59psi/SporePrint/docs/dual-repo-architecture.md

# Dual-Repository Architecture

Open-source Pi-side core + private commercial cloud layer. The commercial repo consumes the open-source one as a git submodule and adds the cloud relay, the browser cloud-web shell and the subscription / admin layer. A React Native mobile app is being rebuilt there and is not released.

**v3.4 business-model clarification**: this public repo (the Pi side) is free, open-source AGPL-3.0. The private repo (cloud + cloud-web, and the mobile app once it ships) is entirely a paid commercial product — `require_premium` (402 `subscription_required`) gates every cloud data endpoint, the cloud relay refuses free Socket.IO clients, and the cloud-web edge middleware redirects free users to `/pricing?upsell=1`. That doesn't change anything about the Pi's behavior or the git-submodule coupling documented below. It does mean that if you're running the Pi standalone without a commercial subscription, the "commercial layer" half of this diagram is invisible to you — and that's a supported configuration.

**v4 layout shift on the private side**: the private browser surfaces and the Pi dashboard source now live in one pnpm monorepo. There is no released mobile app. The cloud web app is a Next.js 16 App Router app that ships **inside the same Railway service and Docker image** as the FastAPI cloud (`cloud/`). There is no `api.sporeprint.ai` subdomain and no separate Railway service — Next.js binds to `$PORT` and proxies `/api/*`, `/socket.io/*`, `/health/*`, `/docs/*`, `/firmware/*`, `/subscriptions/*`, `/webhooks/*` to FastAPI on internal `127.0.0.1:9001`. From this Pi-side repo's perspective, none of that matters: the cloud connector still talks to `https://sporeprint.ai`.

```mermaid
flowchart TB
    subgraph Public["PUBLIC · sporeprint · AGPL-3.0 · github.com/59psi/SporePrint"]
        Server["Pi Server<br/>Python 3.11+ · FastAPI<br/>20 modules · 150 endpoints<br/>SQLite · aiomqtt · Socket.IO<br/>Bearer-token gate (v3.3.0)"]
        Firmware["Firmware<br/>C++ · PlatformIO · Arduino-ESP32 core 3.3<br/>Unified node (climate · relay · lighting) + camera<br/>(AI-Thinker + 3 ESP32-S3 camera boards)<br/>Auth'd MQTT · signed commands · OTA pwd + rollback<br/>signed OTA manifests · offline buffer · health · coredump ack"]
        WebUI["Web UI (compiled bundle in ui/dist)<br/>React 19 · Vite 8 · Tailwind v4<br/>21 pages · @sporeprint/design · REST<br/>Chambers · Sessions · Species<br/>Automation · Vision · Builder"]
    end

    subgraph Private["PRIVATE · Commercial Layer · Paid"]
        Cloud["Cloud Backend (FastAPI + Socket.IO)<br/>Relay · Auth · Push · AI<br/>Metrics · Subscriptions<br/>HMAC-signed commands (v3.3.1)<br/>FastAPI on internal 127.0.0.1:9001<br/>(Next on $PORT, same Railway image)"]
        CloudWeb["Cloud-Web (Next.js 16 App Router)<br/>Server-rendered React<br/>Edge tier middleware<br/>Stripe Checkout · Web push (VAPID)<br/>Same Railway image, public on $PORT"]
        Mobile["Mobile App (React Native)<br/>being rebuilt · not released"]
    end

    Private -.->|git submodule · generated species, phase + Builder data| Public

    Services["Cloud-side services<br/>Supabase · Railway · RevenueCat · Stripe · Firebase<br/>Resend · Sentry · Cloudflare · Claude (cloud AI)"]
    PiExt["Pi-side, optional<br/>Claude API (your own key) · weather providers<br/>(Open-Meteo · OpenWeatherMap · NWS)"]

    Cloud --- Services
    Server -.- PiExt

    classDef public fill:#1a2a1f,stroke:#3dd68c,color:#dfd;
    classDef private fill:#1a1f2a,stroke:#6b93d6,color:#ddf;
    classDef svc fill:#231a2a,stroke:#a06bd6,color:#e8d8ff;
    class Server,Firmware,WebUI public;
    class Cloud,CloudWeb,Mobile private;
    class Services,PiExt svc;
```

## Tier model at the boundary (v3.4+ / v4)

| Capability | Free (Pi self-host, OSS) | Subscription ($4.99/mo · $39.99/yr) |
|---|---|---|
| Pi software (this repo) | ✓ AGPL-3.0, run it yourself | ✓ |
| Pi's own web UI on LAN | ✓ Full control, no paygate | ✓ |
| Remote access | The Pi's own web UI over your own Tailscale | Cloud relay through the web app (HMAC-signed commands) |
| Mobile app | Not available: the React Native app is being rebuilt | Not available yet |
| Cloud-web (`sporeprint.ai`) | ✗ Edge middleware redirects to `/pricing?upsell=1` | ✓ Full |
| Pair Pi to commercial cloud | ✗ (`/devices/pair` → 402) | ✓ |
| Push notifications | ntfy on the Pi (LAN) | ntfy on the Pi, plus browser notifications from `sporeprint.ai` (Web Push) |
| AI vision + advisor on the Pi | ✓ BYOK (your own Anthropic key, stored on the Pi) | ✓ BYOK on-Pi OR cloud-managed |
| Cloud AI (`/ai/*`) | ✗ (`require_premium` returns 402) | ✓ rate-limited or BYOK for unlimited |
| Cultures / Experiments / Planner (cloud) | ✗ | ✓ (added in v4) |
| Analytics / export / historical data durability | ✗ | ✓ |

Key boundary: the Pi itself has **no paygate**. All paywalling lives in the commercial cloud (`require_premium` for REST, `subscription_required` for relay Socket.IO) and the cloud-web edge middleware (`tier === 'premium'` check on every protected route). A Pi-only user never encounters either.

## Repo coupling contract

- The private repo **pins** a specific public-repo SHA (the submodule gitlink in its tree; `.gitmodules` holds only the path and URL). Bumping it is an explicit `git add sporeprint/` + commit, never a floating pointer.
- **Lockstep version bumps**: the parent's `scripts/bump.sh` is the single authority — it edits `cloud/pyproject.toml` (the canonical version), `sporeprint/server/pyproject.toml`, `sporeprint/server/app/main.py`, `sporeprint/firmware/VERSION.txt`, the Pi README's `**Version:**` line and the monorepo's own packages (the Pi UI's version lives in `frontend/packages/pi-ui`; `ui/dist` is rebuilt out of band) so every shipped artifact reports the same version. The Pi-side does not have its own `bump.sh`.
- **Pi UI source vs bundle**: the source lives in the parent at `frontend/packages/pi-ui/`; the compiled output lands in the submodule at `sporeprint/ui/dist/`. The submodule's `.gitignore` has an explicit `!ui/dist/` exception so the prebuilt bundle is committed. The Pi pulls the submodule and serves the bundle locally — no Node toolchain required on the Pi.
- The species library auto-syncs: `frontend/packages/design/src/data/speciesProfiles.ts` is generated from `sporeprint/server/app/species/profiles.py` by the parent's `scripts/port_species.py`, so the Pi remains the source of truth for the 74-entry library; `scripts/port_enums.py` generates the dashboard's phase list from the Pi's `GrowPhase`, and `scripts/port_builder.py` the Builder page's built-in BOM, model and firmware data.
- The private repo **never modifies** submodule files in-place from cloud-side branches. Submodule edits land via a branch + PR inside `sporeprint/`, then the parent bumps the pointer via `scripts/bump.sh` and `scripts/sync-after-merge.sh` (the post-merge script reconciles the submodule SHA after GitHub's squash-merge rewrites).
- The public-repo tests (`cd sporeprint/server && pytest`) must stay green after any private-repo-driven public change. No CI runs on push or PR, so the local checks (`AGENTS.md` → Commands) and the release checklist are the gate.

## What lives where (v4)

| Concern | Public (sporeprint) | Private (commercial cloud) |
|---|---|---|
| Telemetry ingest | ✅ mqtt.py + aiosqlite | — |
| Automation engine | ✅ (safety watchdog, overrides, rules) | — |
| Pi local UI source code | — | ✅ (parent monorepo) |
| Pi local UI compiled bundle | ✅ `sporeprint/ui/dist/` (git-tracked via `!ui/dist/` exception) | builds into the submodule |
| Vision stub + Claude via Pi | ✅ | — |
| Mobile client | — | ✅ rebuild in progress, not released |
| Cloud-web shell (Next.js 16) | — | ✅ |
| Cloud relay + Socket.IO rooms | — | ✅ |
| Auth (Supabase JWT verify) | — | ✅ |
| Subscriptions (RevenueCat mobile + Stripe web) | — | ✅ |
| Admin (overrides, promos, broadcasts) | — | ✅ |
| ESP32 firmware | ✅ | — |
| Cloud HMAC command signing | verify side | sign side (both at v3.3.1+) |
| OTA bundle signing (Ed25519) | verify on Pi (signed release manifest, `server/app/cloud/ota_manifest.py`); optional manifest check on nodes built with the key; node images signed by this repo's `firmware-release.yml` | Pi-server bundle: signed by the commercial release workflow with `sporeprint/scripts/` |
