59psi/SporePrint/firmware/boards/board_profile_esp32s3.h

#pragma once
//
// Board profile — ESP32-S3-DevKitC-1, platformio envs:
//   node_esp32s3          N8 / N8R8 / N16R8 (quad flash)
//   node_esp32s3_n32r16v  N32R16V (octal flash + octal PSRAM, 1.8 V —
//                         ESP32-S3-WROOM-2 module); defines
//                         SP_BOARD_ESP32S3_N32R16V
//
// One pin map for both. Pin choices avoid: strapping pins (0, 3, 45, 46),
// native USB (19, 20), flash/PSRAM (26–37 on octal modules — the whole
// 26-37 range is the octal bus on the WROOM-2), GPIO 47/48 (1.8 V on the
// N32R16V), and the v1.1 RGB LED (38). SDA/SCL match the DevKitC-1 silk
// defaults. BENCH VERIFICATION PENDING — the BOM keeps WROOM-32 canonical
// until an S3 board passes the checklist.
//
// Included ONLY from src/ composition roots — never from lib/.

#if defined(SP_BOARD_ESP32S3_N32R16V)
#define SP_BOARD_NAME "esp32-s3-devkitc-1-n32r16v"
#else
#define SP_BOARD_NAME "esp32-s3-devkitc-1"
#endif

#define SP_PIN_I2C_SDA 8
#define SP_PIN_I2C_SCL 9

#define SP_CHANNEL_PINS {4, 5, 6, 7}
#define SP_CHANNEL_COUNT 4

#define SP_PIN_HX711_DOUT 10
#define SP_PIN_HX711_SCK 11
#define SP_PIN_REED 12  // full GPIO on S3 — internal pullup works here

#define SP_UART_CO2_RX 16
#define SP_UART_CO2_TX 17

// Factory reset — BOOT button (GPIO 0; read-only use is strapping-safe).
#define SP_PIN_FACTORY_RESET 0

// LEDC: S3 has exactly 8 channels — the bank takes channels 0-3 on ONE timer
// (ledcAttachChannel in src/node/main.cpp); nothing else may claim LEDC on
// this board. Clock: the core runs S3 LEDC from the 40 MHz XTAL — 40 MHz /
// 2^10 = 39 kHz is the 10-bit ceiling, and 25 kHz is the exact divider
// 1.5625 (the LEDC divider has 8 fractional bits).
#define SP_LEDC_FREQ_HZ 25000
#define SP_LEDC_RES_BITS 10
