59psi/SporePrint/server/app/automation/templates.py

"""Built-in automation rule templates seeded on startup."""

from .models import (
    AutomationRule,
    RuleCondition,
    RuleAction,
    ConditionType,
    ThresholdCondition,
    ScheduleCondition,
    CompoundCondition,
    CompoundOp,
)

# Phases in which the substrate sits OPEN in the chamber air and the closet
# holds a humidity / CO2 band and a photoperiod for it: the fruiting run, plus
# shiitake's browning stage — the unbagged block browns at 70-80 % RH, CO2
# under its moderate ceiling, 12/12 light, and the engine's stage alerts
# already page on that band, so the rules that answer them must run there too.
# Scheduled FAE stays fruiting-only (browning is fae_mode="passive").
_OPEN_SUBSTRATE_PHASES = ("browning", "primordia_induction", "fruiting")

BUILTIN_RULES: list[AutomationRule] = [
    # ─── Humidity Control ────────────────────────────────────────
    AutomationRule(
        name="Humidity Boost",
        description="Activate humidifier when humidity drops below species target minimum",
        priority=10,
        condition=RuleCondition(
            type=ConditionType.THRESHOLD,
            threshold=ThresholdCondition(
                sensor="humidity",
                operator="lt",
                profile_ref="humidity_min",
            ),
        ),
        action=RuleAction(target="plug-humidifier", state="on", duration_sec=300),
        cooldown_seconds=120,
        safety_max_on_seconds=1800,
        notification=False,
        log_to_session=True,
    ),
    AutomationRule(
        name="Humidity Cut",
        description="Deactivate humidifier when humidity exceeds species target maximum",
        priority=10,
        condition=RuleCondition(
            type=ConditionType.THRESHOLD,
            threshold=ThresholdCondition(
                sensor="humidity",
                operator="gt",
                profile_ref="humidity_max",
            ),
        ),
        action=RuleAction(target="plug-humidifier", state="off"),
        cooldown_seconds=60,
        log_to_session=True,
    ),
    # Humidity was ONE-DIRECTIONAL until now: the humidifier turned on and off,
    # but nothing REMOVED humidity. A sealed chamber pinned at 95% RH is a
    # contamination event, and Tier 3 ships a dehumidifier plug for exactly it.
    AutomationRule(
        name="Dehumidify",
        description="Run the dehumidifier when humidity exceeds the species maximum",
        priority=10,
        applies_to_phases=list(_OPEN_SUBSTRATE_PHASES),
        condition=RuleCondition(
            type=ConditionType.THRESHOLD,
            threshold=ThresholdCondition(sensor="humidity", operator="gt", profile_ref="humidity_max"),
        ),
        action=RuleAction(target="plug-dehumidifier", state="on", duration_sec=600),
        cooldown_seconds=300,
        safety_max_on_seconds=3600,
        log_to_session=True,
    ),
    # Like the heating/cooling cutoffs, this is true the whole time the chamber
    # is in range, so it stays out of the session timeline (it wrote ~1,440
    # events a day there). The firing history still records it. It stops a
    # deadband below the maximum (humidity_dehumidify_off = humidity_max - d,
    # d = 3 %RH, at most a quarter of the band), not at it, so noise at the
    # edge does not cycle the dehumidifier.
    AutomationRule(
        name="Dehumidify Cutoff",
        description="Stop the dehumidifier once humidity is back within range, past the deadband",
        priority=10,
        applies_to_phases=list(_OPEN_SUBSTRATE_PHASES),
        condition=RuleCondition(
            type=ConditionType.THRESHOLD,
            threshold=ThresholdCondition(sensor="humidity", operator="lt",
                                         profile_ref="humidity_dehumidify_off"),
        ),
        action=RuleAction(target="plug-dehumidifier", state="off"),
        cooldown_seconds=60,
        log_to_session=False,
    ),
    # Graceful degradation: no dehumidifier? Shed humidity by exchanging chamber
    # air with (drier) ambient using the exhaust fan. This is how a monotub
    # without a dehumidifier is actually managed. `requires_absent_target` makes
    # it go silent the moment a real dehumidifier is paired, so the two never
    # fight. Note the tradeoff: venting also sheds CO2 and heat — so this runs
    # only with the substrate open (browning + fruiting; colonization's
    # fae_mode=none already blocks it via the air-exchange guard) and is
    # deliberately gentler than the emergency exhaust.
    AutomationRule(
        name="Humidity Vent (no dehumidifier)",
        description="Vent moist air with the exhaust fan when humidity is high and no dehumidifier is present",
        priority=9,
        applies_to_phases=list(_OPEN_SUBSTRATE_PHASES),
        requires_absent_target="plug-dehumidifier",
        condition=RuleCondition(
            type=ConditionType.THRESHOLD,
            threshold=ThresholdCondition(sensor="humidity", operator="gt", profile_ref="humidity_max"),
        ),
        action=RuleAction(target="relay-01", channel="exhaust", state="on", pwm=180, duration_sec=180),
        cooldown_seconds=600,
        safety_max_on_seconds=900,
        log_to_session=True,
    ),
    # Circulation fan — kept a steady low cycle during fruiting so the chamber
    # doesn't stratify (CO2 pools low, RH pockets form, pins dry unevenly). It
    # is NOT fresh-air exchange — it stirs the air already in the chamber — so
    # it runs even when fae_mode="none" holds the FAE/exhaust fans off. Cadence
    # is species-driven via the scheduler; falls back to the literal.
    AutomationRule(
        name="Circulation Cycle",
        description="Periodic internal air circulation during fruiting to prevent stratification",
        priority=4,
        applies_to_phases=["primordia_induction", "fruiting"],
        condition=RuleCondition(
            type=ConditionType.SCHEDULE,
            schedule=ScheduleCondition(profile_interval_ref="circulation_interval_min", interval_min=30),
        ),
        action=RuleAction(target="relay-01", channel="circulation", state="on", pwm=160, duration_sec=120),
        cooldown_seconds=600,
        log_to_session=True,
    ),
    # Misting pump (relay aux / GPIO 14) as the HUMIDIFIER's fallback — symmetric
    # with the exhaust-vent fallback for the dehumidifier. If no humidifier plug
    # is paired, a brief mist raises RH. Gated HARD: short pulse, long cooldown,
    # tight safety cutoff — over-misting causes bacterial blotch, and we have no
    # substrate-moisture sensor to close the loop, so this stays conservative and
    # only runs when there is genuinely no other way to add humidity.
    AutomationRule(
        name="Mist (no humidifier)",
        description="Brief misting pulse when humidity is low and no humidifier plug is present",
        priority=9,
        applies_to_phases=list(_OPEN_SUBSTRATE_PHASES),
        requires_absent_target="plug-humidifier",
        condition=RuleCondition(
            type=ConditionType.THRESHOLD,
            threshold=ThresholdCondition(sensor="humidity", operator="lt", profile_ref="humidity_min"),
        ),
        action=RuleAction(target="relay-01", channel="aux", state="on", pwm=255, duration_sec=8),
        cooldown_seconds=600,
        safety_max_on_seconds=30,
        log_to_session=True,
    ),

    # ─── CO2 / FAE Control ──────────────────────────────────────
    AutomationRule(
        name="CO2 FAE Trigger",
        description="Vent when CO2 exceeds the species' fruiting/pinning ceiling",
        priority=8,
        # Open-substrate phases only (browning + the fruiting run). Colonization
        # WANTS high CO2 (5000-15000ppm at zero FAE — Stamets & Chilton); this
        # rule used to have no phase gate and latched the fan on from day one of
        # the spawn run, drying the substrate and venting the CO2 the mycelium
        # needs. The fae_mode guard in the engine backstops this, but the phase
        # gate makes the intent explicit.
        applies_to_phases=list(_OPEN_SUBSTRATE_PHASES),
        condition=RuleCondition(
            type=ConditionType.THRESHOLD,
            threshold=ThresholdCondition(
                sensor="co2_ppm",
                operator="gt",
                profile_ref="co2_max_ppm",
            ),
        ),
        action=RuleAction(target="relay-01", channel="fae", state="on", pwm=200, duration_sec=300),
        cooldown_seconds=300,
        safety_max_on_seconds=1800,
        log_to_session=True,
    ),
    AutomationRule(
        name="Emergency CO2 Exhaust",
        description="Hard exhaust when CO2 runs above the species' emergency edge",
        priority=20,
        # Open-substrate phases only AND species-relative. The old hardcoded 3000 was normal —
        # even low — for a reishi antler fruiting (1000-10000ppm) or a maitake
        # rosette, so it fought species that legitimately hold CO2 high. Now it
        # fires at co2_emergency_ppm = the phase's co2_max_ppm + its margin, so
        # "emergency" means the same distance above target for every species.
        applies_to_phases=list(_OPEN_SUBSTRATE_PHASES),
        condition=RuleCondition(
            type=ConditionType.THRESHOLD,
            threshold=ThresholdCondition(
                sensor="co2_ppm",
                operator="gt",
                profile_ref="co2_emergency_ppm",
            ),
        ),
        action=RuleAction(target="relay-01", channel="exhaust", state="on", pwm=255, duration_sec=600),
        cooldown_seconds=120,
        notification=True,
        log_to_session=True,
    ),
    AutomationRule(
        name="CO2 Hard Ceiling",
        description="Absolute exhaust backstop — vents no matter the species or phase",
        priority=21,
        # The species-relative emergency above needs a phase profile to resolve.
        # This is the profile-independent floor under it: a level (40000ppm) far
        # above any legitimate cultivation band, including a 10-40k colonization,
        # so it never fights a real grow — but it still protects the equipment
        # and anyone in the room if CO2 runs away with no active grow profile.
        # At or above, not above: 40000 is the SCD30 / SCD4x full scale, so a
        # saturated sensor reads exactly 40000 and "> 40000" never fired.
        condition=RuleCondition(
            type=ConditionType.THRESHOLD,
            threshold=ThresholdCondition(sensor="co2_ppm", operator="gte", value=40000),
        ),
        action=RuleAction(target="relay-01", channel="exhaust", state="on", pwm=255, duration_sec=600),
        cooldown_seconds=120,
        notification=True,
        log_to_session=True,
    ),
    AutomationRule(
        name="Scheduled FAE Cycle",
        description="Periodic FAE — period and duration come from the species' grow profile",
        priority=5,
        applies_to_phases=["primordia_induction", "fruiting"],
        condition=RuleCondition(
            type=ConditionType.SCHEDULE,
            # The profile already states how often each phase wants fresh air
            # (fae_interval_min: 20 for oyster fruiting, 30 for primordia…).
            # This was hardcoded to 20 for every species and every phase, so the
            # numbers in the grow profile were decorative. interval_min stays as
            # the fallback for a profile that doesn't specify one.
            schedule=ScheduleCondition(profile_interval_ref="fae_interval_min", interval_min=20),
        ),
        action=RuleAction(
            target="relay-01", channel="fae", state="on", pwm=180,
            duration_profile_ref="fae_duration_sec", duration_sec=300,
        ),
        cooldown_seconds=600,
        log_to_session=True,
    ),

    # ─── Temperature Control ────────────────────────────────────
    AutomationRule(
        name="Heating Trigger",
        description="Activate heater when temperature drops below species target minimum",
        priority=9,
        condition=RuleCondition(
            type=ConditionType.THRESHOLD,
            threshold=ThresholdCondition(
                sensor="temp_f",
                operator="lt",
                profile_ref="temp_min_f",
            ),
        ),
        action=RuleAction(target="plug-heater", state="on", duration_sec=600),
        cooldown_seconds=300,
        safety_max_on_seconds=3600,
        log_to_session=True,
    ),
    AutomationRule(
        name="Cooling Trigger",
        description="Activate cooler when temperature exceeds species target maximum",
        priority=9,
        condition=RuleCondition(
            type=ConditionType.THRESHOLD,
            threshold=ThresholdCondition(
                sensor="temp_f",
                operator="gt",
                profile_ref="temp_max_f",
            ),
        ),
        action=RuleAction(target="plug-cooler", state="on", duration_sec=600),
        cooldown_seconds=300,
        safety_max_on_seconds=3600,
        log_to_session=True,
    ),
    # The cutoffs switch off a deadband INSIDE the band (temp_heat_off_f =
    # temp_min_f + d, temp_cool_off_f = temp_max_f - d; d is 1 °F, at most a
    # quarter of the band). Switching off at the same edge the trigger switches
    # on made sensor noise at the edge cycle the plug every few minutes: relay
    # wear on every plug, short-cycling on a compressor cooler.
    AutomationRule(
        name="Heating Cutoff",
        description="Turn off heater once temperature is back inside the band, past the deadband",
        priority=10,
        condition=RuleCondition(
            type=ConditionType.THRESHOLD,
            threshold=ThresholdCondition(
                sensor="temp_f",
                operator="gte",
                profile_ref="temp_heat_off_f",
            ),
        ),
        action=RuleAction(target="plug-heater", state="off"),
        cooldown_seconds=60,
        log_to_session=False,
    ),
    AutomationRule(
        name="Cooling Cutoff",
        description="Turn off cooler once temperature is back inside the band, past the deadband",
        priority=10,
        condition=RuleCondition(
            type=ConditionType.THRESHOLD,
            threshold=ThresholdCondition(
                sensor="temp_f",
                operator="lte",
                profile_ref="temp_cool_off_f",
            ),
        ),
        action=RuleAction(target="plug-cooler", state="off"),
        cooldown_seconds=60,
        log_to_session=False,
    ),

    # ─── Photoperiod ────────────────────────────────────────────
    # These two rules ARE the light cycle. The window comes from the species'
    # light_hours_on for the active phase, so a 12/12 species runs 12/12 and a
    # 16/8 species runs 16/8 from the same pair of rules.
    #
    # Previously both light rules were `interval_min=60` re-assertions of a
    # fixed scene, which meant the profile's light_hours_on/off were never read:
    # fruiting lights were simply ON forever, and there was no dark period at
    # all. Photoperiod is not cosmetic for mushrooms — it's a fruiting trigger.
    AutomationRule(
        name="Photoperiod — Lights On",
        description="Lights on during the species' light window for this phase",
        priority=3,
        applies_to_phases=list(_OPEN_SUBSTRATE_PHASES),
        condition=RuleCondition(
            type=ConditionType.SCHEDULE,
            schedule=ScheduleCondition(photoperiod="on", photoperiod_start="06:00"),
        ),
        action=RuleAction(target="light-01", scene="fruiting_standard"),
        cooldown_seconds=1800,
        log_to_session=True,
    ),
    AutomationRule(
        name="Photoperiod — Lights Off",
        description="Lights off outside the species' light window (the dark period)",
        priority=3,
        applies_to_phases=list(_OPEN_SUBSTRATE_PHASES),
        condition=RuleCondition(
            type=ConditionType.SCHEDULE,
            schedule=ScheduleCondition(photoperiod="off", photoperiod_start="06:00"),
        ),
        action=RuleAction(target="light-01", scene="colonization_dark", state="off"),
        cooldown_seconds=1800,
        log_to_session=True,
    ),
    AutomationRule(
        name="Light Scene — Colonization Dark",
        description="Ensure lights off during colonization and rest (profile: light_hours_on = 0)",
        priority=3,
        # Rest runs with the lights off too (the engine resolves it with
        # light_hours_on = 0), and no photoperiod rule covers it: without rest
        # here, a grow advanced to rest inside its light window kept the
        # fruiting scene on for the whole rest.
        applies_to_phases=["substrate_colonization", "grain_colonization", "rest"],
        condition=RuleCondition(
            type=ConditionType.SCHEDULE,
            # photoperiod="off" with light_hours_on=0 is always true — the
            # window never opens for a dark phase. Same mechanism, no special case.
            schedule=ScheduleCondition(photoperiod="off"),
        ),
        action=RuleAction(target="light-01", scene="colonization_dark", state="off"),
        cooldown_seconds=3600,
        log_to_session=True,
    ),

    # ─── SPECIES-SPECIFIC RULES ─────────────────────────────────

    # Lion's Mane — Temperature Swing Scheduler. Priority 11 puts it above the
    # generic Cooling Cutoff (10), which is true across the whole 60-65 °F band
    # this rule cools through. The engine gives an actuator to the highest-
    # priority rule whose condition holds; at 7 the cutoff switched the cooler
    # straight back off and the swing never happened.
    AutomationRule(
        name="Lion's Mane Night Cool",
        description="Cool down for lion's mane temp swing requirement (night cycle 10pm-6am)",
        priority=11,
        applies_to_species=["lions_mane"],
        applies_to_phases=["primordia_induction"],
        condition=RuleCondition(
            type=ConditionType.COMPOUND,
            compound=CompoundCondition(
                op=CompoundOp.AND,
                conditions=[
                    RuleCondition(
                        type=ConditionType.SCHEDULE,
                        schedule=ScheduleCondition(time_range=("22:00", "06:00")),
                    ),
                    RuleCondition(
                        type=ConditionType.THRESHOLD,
                        threshold=ThresholdCondition(sensor="temp_f", operator="gt", value=60),
                    ),
                ],
            ),
        ),
        action=RuleAction(target="plug-cooler", state="on", duration_sec=1800),
        cooldown_seconds=1800,
        safety_max_on_seconds=7200,
        log_to_session=True,
    ),

    # CO2 FLOOR — species that want CO2 held HIGH, not just capped.
    # This replaces two hardcoded species rules (reishi <1500, king_trumpet
    # <1000) with one profile-driven rule. Reishi antler morphology and king
    # trumpet primordia both need elevated CO2; the value now lives in the
    # profile's co2_min_ppm (see models.py), so any species that sets it gets
    # the same behaviour without a bespoke rule. Only fires when a floor is set
    # AND the reading is below it — species with co2_min_ppm=None never trigger.
    AutomationRule(
        name="CO2 Floor — Restrict FAE",
        description="Hold FAE off when CO2 drops below the species' floor for this phase",
        priority=12,
        condition=RuleCondition(
            type=ConditionType.THRESHOLD,
            threshold=ThresholdCondition(
                sensor="co2_ppm",
                operator="lt",
                profile_ref="co2_min_ppm",
            ),
        ),
        action=RuleAction(target="relay-01", channel="fae", state="off"),
        cooldown_seconds=300,
        log_to_session=True,
    ),

    # Cordyceps — Blue light enforcement. It holds the light during the
    # species' light window, outranking the generic Photoperiod — Lights On
    # (which would otherwise swap in the white fruiting scene), and lets go for
    # the dark period so Photoperiod — Lights Off still gives it 16/8. It used
    # to re-assert blue every 60 min around the clock.
    AutomationRule(
        name="Cordyceps Blue Light",
        description="Blue-only lighting for cordyceps militaris during the species' light window",
        priority=7,
        applies_to_species=["cordyceps_militaris"],
        applies_to_phases=["primordia_induction", "fruiting"],
        condition=RuleCondition(
            type=ConditionType.SCHEDULE,
            schedule=ScheduleCondition(photoperiod="on", photoperiod_start="06:00"),
        ),
        action=RuleAction(target="light-01", scene="cordyceps_blue"),
        cooldown_seconds=3600,
        log_to_session=True,
    ),

    # ─── Weather-Aware Rules ────────────────────────────────────
    # The two forecast rules outrank the Cooling Cutoff (10), so while their
    # condition holds they keep the cooler on for their duration_sec instead of
    # being switched off in the same pass. That is only safe with a chamber-
    # temperature gate: they cool a chamber sitting in the upper half of its
    # band (temp_mid_f = midpoint of the phase's range) and let go at the
    # midpoint, never chilling a warm-loving species toward its floor (or into a
    # heater/cooler fight).
    AutomationRule(
        name="Pre-cool for Hot Forecast",
        description=(
            "Run the cooler when today's forecast high exceeds 90°F and the chamber "
            "is in the upper half of its temperature band, to preempt closet warming"
        ),
        priority=11,
        condition=RuleCondition(
            type=ConditionType.COMPOUND,
            compound=CompoundCondition(
                op=CompoundOp.AND,
                conditions=[
                    RuleCondition(
                        type=ConditionType.THRESHOLD,
                        threshold=ThresholdCondition(
                            sensor="forecast_high_f", operator="gt", value=90.0,
                        ),
                    ),
                    RuleCondition(
                        type=ConditionType.THRESHOLD,
                        threshold=ThresholdCondition(
                            sensor="temp_f", operator="gt", profile_ref="temp_mid_f",
                        ),
                    ),
                ],
            ),
        ),
        action=RuleAction(target="plug-cooler", state="on", duration_sec=900),
        cooldown_seconds=1800,
        notification=True,
        log_to_session=True,
    ),

    # Pre-emptive boost for dry weather. It used to be outdoor RH alone: no
    # chamber reading, no phase gate, no ceiling — and plugs ignore
    # duration_sec — so every dry winter day ran the humidifier around the
    # clock (humidity_max is 100 in colonization, so Humidity Cut never fired).
    # Now it only tops the chamber up toward its ceiling while fruiting, and the
    # safety ceiling bounds any single run.
    AutomationRule(
        name="Dry Weather Humidity Boost",
        description=(
            "Pre-emptively run the humidifier while fruiting when outdoor humidity "
            "drops below 25% (dry air infiltrates the closet) and the chamber is "
            "still below its humidity ceiling"
        ),
        priority=8,
        applies_to_phases=["primordia_induction", "fruiting"],
        condition=RuleCondition(
            type=ConditionType.COMPOUND,
            compound=CompoundCondition(
                op=CompoundOp.AND,
                conditions=[
                    RuleCondition(
                        type=ConditionType.THRESHOLD,
                        threshold=ThresholdCondition(
                            sensor="outdoor_humidity", operator="lt", value=25.0,
                        ),
                    ),
                    RuleCondition(
                        type=ConditionType.THRESHOLD,
                        threshold=ThresholdCondition(
                            sensor="humidity", operator="lt", profile_ref="humidity_max",
                        ),
                    ),
                ],
            ),
        ),
        action=RuleAction(target="plug-humidifier", state="on", duration_sec=600),
        cooldown_seconds=600,
        safety_max_on_seconds=1800,
        log_to_session=True,
    ),

    AutomationRule(
        name="Heat Wave Warning",
        description=(
            "Alert and run the cooler when the forecast high exceeds 95°F and the chamber is "
            "in the upper half of its band — may not maintain cold-fruiting species targets"
        ),
        priority=15,
        enabled=True,
        condition=RuleCondition(
            type=ConditionType.COMPOUND,
            compound=CompoundCondition(
                op=CompoundOp.AND,
                conditions=[
                    RuleCondition(
                        type=ConditionType.THRESHOLD,
                        threshold=ThresholdCondition(
                            sensor="forecast_high_f", operator="gt", value=95.0,
                        ),
                    ),
                    RuleCondition(
                        type=ConditionType.THRESHOLD,
                        threshold=ThresholdCondition(
                            sensor="temp_f", operator="gt", profile_ref="temp_mid_f",
                        ),
                    ),
                ],
            ),
        ),
        action=RuleAction(target="plug-cooler", state="on", duration_sec=1800),
        cooldown_seconds=3600,
        notification=True,
        log_to_session=True,
    ),
]


# Built-in rules whose SHIPPED definition was later found unsafe or broken,
# exactly as they shipped, keyed by name. seed_builtin_rules never re-seeds a
# rule a Pi already has, so an existing install would keep the old copy forever;
# instead it upgrades a stored rule to the current BUILTIN_RULES entry (priority included)
# while — and only while — its behaviour and priority still match the legacy
# form. An operator-edited rule is never overwritten.
LEGACY_BUILTIN_RULES: dict[str, AutomationRule] = {
    # Outdoor RH alone: no chamber reading, no phase gate, no safety ceiling.
    "Dry Weather Humidity Boost": AutomationRule(
        name="Dry Weather Humidity Boost",
        description="Increase humidifier when outdoor humidity drops below 25% (dry air infiltrates closet)",
        priority=8,
        condition=RuleCondition(
            type=ConditionType.THRESHOLD,
            threshold=ThresholdCondition(sensor="outdoor_humidity", operator="lt", value=25.0),
        ),
        action=RuleAction(target="plug-humidifier", state="on", duration_sec=600),
        cooldown_seconds=600,
        log_to_session=True,
    ),
    # Priority 7 — below the Cooling Cutoff, which switched the cooler back off.
    "Lion's Mane Night Cool": AutomationRule(
        name="Lion's Mane Night Cool",
        description="Cool down for lion's mane temp swing requirement (night cycle 10pm-6am)",
        priority=7,
        applies_to_species=["lions_mane"],
        applies_to_phases=["primordia_induction"],
        condition=RuleCondition(
            type=ConditionType.COMPOUND,
            compound=CompoundCondition(
                op=CompoundOp.AND,
                conditions=[
                    RuleCondition(
                        type=ConditionType.SCHEDULE,
                        schedule=ScheduleCondition(time_range=("22:00", "06:00")),
                    ),
                    RuleCondition(
                        type=ConditionType.THRESHOLD,
                        threshold=ThresholdCondition(sensor="temp_f", operator="gt", value=60),
                    ),
                ],
            ),
        ),
        action=RuleAction(target="plug-cooler", state="on", duration_sec=1800),
        cooldown_seconds=1800,
        safety_max_on_seconds=7200,
        log_to_session=True,
    ),
    # Blue re-asserted every 60 min around the clock — no dark period.
    "Cordyceps Blue Light": AutomationRule(
        name="Cordyceps Blue Light",
        description="Enforce blue-only lighting for cordyceps militaris fruiting",
        priority=7,
        applies_to_species=["cordyceps_militaris"],
        applies_to_phases=["primordia_induction", "fruiting"],
        condition=RuleCondition(
            type=ConditionType.SCHEDULE,
            schedule=ScheduleCondition(interval_min=60),
        ),
        action=RuleAction(target="light-01", scene="cordyceps_blue"),
        cooldown_seconds=3600,
        log_to_session=True,
    ),
    # Forecast alone, no chamber-temperature gate: now that it outranks the
    # Cooling Cutoff it would hold the cooler on whatever the chamber reads.
    "Pre-cool for Hot Forecast": AutomationRule(
        name="Pre-cool for Hot Forecast",
        description="Activate cooler when today's forecast high exceeds 90°F to preempt closet warming",
        priority=11,
        condition=RuleCondition(
            type=ConditionType.THRESHOLD,
            threshold=ThresholdCondition(sensor="forecast_high_f", operator="gt", value=90.0),
        ),
        action=RuleAction(target="plug-cooler", state="on", duration_sec=900),
        cooldown_seconds=1800,
        notification=True,
        log_to_session=True,
    ),
    "Heat Wave Warning": AutomationRule(
        name="Heat Wave Warning",
        description="Send alert when forecast high exceeds 95°F — may not maintain cold-fruiting species targets",
        priority=15,
        enabled=True,
        condition=RuleCondition(
            type=ConditionType.THRESHOLD,
            threshold=ThresholdCondition(sensor="forecast_high_f", operator="gt", value=95.0),
        ),
        action=RuleAction(target="plug-cooler", state="on", duration_sec=1800),
        cooldown_seconds=3600,
        notification=True,
        log_to_session=True,
    ),
    # Logged a session event every minute while humidity was in range.
    "Dehumidify Cutoff": AutomationRule(
        name="Dehumidify Cutoff",
        description="Stop the dehumidifier once humidity is back within range",
        priority=10,
        applies_to_phases=["primordia_induction", "fruiting"],
        condition=RuleCondition(
            type=ConditionType.THRESHOLD,
            threshold=ThresholdCondition(sensor="humidity", operator="lt", profile_ref="humidity_max"),
        ),
        action=RuleAction(target="plug-dehumidifier", state="off"),
        cooldown_seconds=60,
        log_to_session=True,
    ),
}


# The eight rules that gained "browning" in their phase gate (see
# _OPEN_SUBSTRATE_PHASES), exactly as they shipped before the shiitake browning
# phase existed. Without these an existing install would keep fruiting-only
# copies (seed_builtin_rules never re-seeds), leaving a browning block with
# stage alerts on its humidity / CO2 band but no rule to answer them. Same
# contract as LEGACY_BUILTIN_RULES: only an unedited copy is upgraded.
_PRE_BROWNING_PHASES = ["primordia_induction", "fruiting"]

PRE_BROWNING_BUILTIN_RULES: dict[str, AutomationRule] = {
    "Dehumidify": AutomationRule(
        name="Dehumidify",
        description="Run the dehumidifier when humidity exceeds the species maximum",
        priority=10,
        applies_to_phases=list(_PRE_BROWNING_PHASES),
        condition=RuleCondition(
            type=ConditionType.THRESHOLD,
            threshold=ThresholdCondition(sensor="humidity", operator="gt", profile_ref="humidity_max"),
        ),
        action=RuleAction(target="plug-dehumidifier", state="on", duration_sec=600),
        cooldown_seconds=300,
        safety_max_on_seconds=3600,
        log_to_session=True,
    ),
    "Dehumidify Cutoff": AutomationRule(
        name="Dehumidify Cutoff",
        description="Stop the dehumidifier once humidity is back within range",
        priority=10,
        applies_to_phases=list(_PRE_BROWNING_PHASES),
        condition=RuleCondition(
            type=ConditionType.THRESHOLD,
            threshold=ThresholdCondition(sensor="humidity", operator="lt", profile_ref="humidity_max"),
        ),
        action=RuleAction(target="plug-dehumidifier", state="off"),
        cooldown_seconds=60,
        log_to_session=False,
    ),
    "Humidity Vent (no dehumidifier)": AutomationRule(
        name="Humidity Vent (no dehumidifier)",
        description="Vent moist air with the exhaust fan when humidity is high and no dehumidifier is present",
        priority=9,
        applies_to_phases=list(_PRE_BROWNING_PHASES),
        requires_absent_target="plug-dehumidifier",
        condition=RuleCondition(
            type=ConditionType.THRESHOLD,
            threshold=ThresholdCondition(sensor="humidity", operator="gt", profile_ref="humidity_max"),
        ),
        action=RuleAction(target="relay-01", channel="exhaust", state="on", pwm=180, duration_sec=180),
        cooldown_seconds=600,
        safety_max_on_seconds=900,
        log_to_session=True,
    ),
    "Mist (no humidifier)": AutomationRule(
        name="Mist (no humidifier)",
        description="Brief misting pulse when humidity is low and no humidifier plug is present",
        priority=9,
        applies_to_phases=list(_PRE_BROWNING_PHASES),
        requires_absent_target="plug-humidifier",
        condition=RuleCondition(
            type=ConditionType.THRESHOLD,
            threshold=ThresholdCondition(sensor="humidity", operator="lt", profile_ref="humidity_min"),
        ),
        action=RuleAction(target="relay-01", channel="aux", state="on", pwm=255, duration_sec=8),
        cooldown_seconds=600,
        safety_max_on_seconds=30,
        log_to_session=True,
    ),
    "CO2 FAE Trigger": AutomationRule(
        name="CO2 FAE Trigger",
        description="Vent when CO2 exceeds the species' fruiting/pinning ceiling",
        priority=8,
        applies_to_phases=list(_PRE_BROWNING_PHASES),
        condition=RuleCondition(
            type=ConditionType.THRESHOLD,
            threshold=ThresholdCondition(sensor="co2_ppm", operator="gt", profile_ref="co2_max_ppm"),
        ),
        action=RuleAction(target="relay-01", channel="fae", state="on", pwm=200, duration_sec=300),
        cooldown_seconds=300,
        safety_max_on_seconds=1800,
        log_to_session=True,
    ),
    "Emergency CO2 Exhaust": AutomationRule(
        name="Emergency CO2 Exhaust",
        description="Hard exhaust when CO2 runs above the species' emergency edge",
        priority=20,
        applies_to_phases=list(_PRE_BROWNING_PHASES),
        condition=RuleCondition(
            type=ConditionType.THRESHOLD,
            threshold=ThresholdCondition(sensor="co2_ppm", operator="gt", profile_ref="co2_emergency_ppm"),
        ),
        action=RuleAction(target="relay-01", channel="exhaust", state="on", pwm=255, duration_sec=600),
        cooldown_seconds=120,
        notification=True,
        log_to_session=True,
    ),
    "Photoperiod — Lights On": AutomationRule(
        name="Photoperiod — Lights On",
        description="Lights on during the species' light window for this phase",
        priority=3,
        applies_to_phases=list(_PRE_BROWNING_PHASES),
        condition=RuleCondition(
            type=ConditionType.SCHEDULE,
            schedule=ScheduleCondition(photoperiod="on", photoperiod_start="06:00"),
        ),
        action=RuleAction(target="light-01", scene="fruiting_standard"),
        cooldown_seconds=1800,
        log_to_session=True,
    ),
    "Photoperiod — Lights Off": AutomationRule(
        name="Photoperiod — Lights Off",
        description="Lights off outside the species' light window (the dark period)",
        priority=3,
        applies_to_phases=list(_PRE_BROWNING_PHASES),
        condition=RuleCondition(
            type=ConditionType.SCHEDULE,
            schedule=ScheduleCondition(photoperiod="off", photoperiod_start="06:00"),
        ),
        action=RuleAction(target="light-01", scene="colonization_dark", state="off"),
        cooldown_seconds=1800,
        log_to_session=True,
    ),
}


# The CO2 Hard Ceiling as it shipped before it tripped AT the sensors' full
# scale: "> 40000" can never fire, because the SCD30 / SCD4x report a
# saturated reading as exactly 40000.
PRE_FULL_SCALE_BUILTIN_RULES: dict[str, AutomationRule] = {
    "CO2 Hard Ceiling": AutomationRule(
        name="CO2 Hard Ceiling",
        description="Absolute exhaust backstop — vents no matter the species or phase",
        priority=21,
        condition=RuleCondition(
            type=ConditionType.THRESHOLD,
            threshold=ThresholdCondition(sensor="co2_ppm", operator="gt", value=40000),
        ),
        action=RuleAction(target="relay-01", channel="exhaust", state="on", pwm=255, duration_sec=600),
        cooldown_seconds=120,
        notification=True,
        log_to_session=True,
    ),
}


# Light Scene — Colonization Dark as it shipped before it covered rest: no
# light rule ran in rest, so a grow advanced to rest inside its light window
# kept the fruiting scene on.
PRE_DARK_REST_BUILTIN_RULES: dict[str, AutomationRule] = {
    "Light Scene — Colonization Dark": AutomationRule(
        name="Light Scene — Colonization Dark",
        description="Ensure lights off during colonization (profile: light_hours_on = 0)",
        priority=3,
        applies_to_phases=["substrate_colonization", "grain_colonization"],
        condition=RuleCondition(
            type=ConditionType.SCHEDULE,
            schedule=ScheduleCondition(photoperiod="off"),
        ),
        action=RuleAction(target="light-01", scene="colonization_dark", state="off"),
        cooldown_seconds=3600,
        log_to_session=True,
    ),
}


# Four built-ins exactly as every release before 5.0.0 shipped them, before
# they were scoped to the phases they serve and read the species profile.
# CO2 FAE Trigger ran in colonization too. Emergency CO2 Exhaust fired at a
# fixed 3000 ppm in every phase; unscoped at priority 20 it now also reads as
# a life-safety rule, which skips the sealed-container and fae_mode gates, so
# it vented colonizing grow bags at full power. The FAE cycle ignored the
# profile's fae_interval_min / fae_duration_sec, and the dark scene was an
# hourly re-assertion with no photoperiod.
PRE_PHASE_GATE_BUILTIN_RULES: dict[str, AutomationRule] = {
    "CO2 FAE Trigger": AutomationRule(
        name="CO2 FAE Trigger",
        description="Activate FAE fan when CO2 exceeds species target maximum",
        priority=8,
        condition=RuleCondition(
            type=ConditionType.THRESHOLD,
            threshold=ThresholdCondition(sensor="co2_ppm", operator="gt", profile_ref="co2_max_ppm"),
        ),
        action=RuleAction(target="relay-01", channel="fae", state="on", pwm=200, duration_sec=300),
        cooldown_seconds=300,
        safety_max_on_seconds=1800,
        log_to_session=True,
    ),
    "Emergency CO2 Exhaust": AutomationRule(
        name="Emergency CO2 Exhaust",
        description="Emergency exhaust activation when CO2 exceeds 3000ppm",
        priority=20,
        condition=RuleCondition(
            type=ConditionType.THRESHOLD,
            threshold=ThresholdCondition(sensor="co2_ppm", operator="gt", value=3000),
        ),
        action=RuleAction(target="relay-01", channel="exhaust", state="on", pwm=255, duration_sec=600),
        cooldown_seconds=120,
        notification=True,
        log_to_session=True,
    ),
    "Scheduled FAE Cycle": AutomationRule(
        name="Scheduled FAE Cycle",
        description="Periodic FAE fan activation every 20 minutes during fruiting phases",
        priority=5,
        applies_to_phases=["primordia_induction", "fruiting"],
        condition=RuleCondition(
            type=ConditionType.SCHEDULE,
            schedule=ScheduleCondition(interval_min=20),
        ),
        action=RuleAction(target="relay-01", channel="fae", state="on", pwm=180, duration_sec=300),
        cooldown_seconds=1200,
        log_to_session=True,
    ),
    "Light Scene — Colonization Dark": AutomationRule(
        name="Light Scene — Colonization Dark",
        description="Ensure lights off during colonization",
        priority=3,
        applies_to_phases=["substrate_colonization", "grain_colonization"],
        condition=RuleCondition(
            type=ConditionType.SCHEDULE,
            schedule=ScheduleCondition(interval_min=60),
        ),
        action=RuleAction(target="light-01", scene="colonization_dark"),
        cooldown_seconds=3600,
        log_to_session=True,
    ),
}


# The three cutoffs as they shipped before they switched off a deadband inside
# the band: off at the very edge the trigger switches on at, so sensor noise
# there cycled the plug every few minutes.
PRE_DEADBAND_BUILTIN_RULES: dict[str, AutomationRule] = {
    "Heating Cutoff": AutomationRule(
        name="Heating Cutoff",
        description="Turn off heater when temperature reaches target",
        priority=10,
        condition=RuleCondition(
            type=ConditionType.THRESHOLD,
            threshold=ThresholdCondition(sensor="temp_f", operator="gte", profile_ref="temp_min_f"),
        ),
        action=RuleAction(target="plug-heater", state="off"),
        cooldown_seconds=60,
        log_to_session=False,
    ),
    "Cooling Cutoff": AutomationRule(
        name="Cooling Cutoff",
        description="Turn off cooler when temperature drops to target",
        priority=10,
        condition=RuleCondition(
            type=ConditionType.THRESHOLD,
            threshold=ThresholdCondition(sensor="temp_f", operator="lte", profile_ref="temp_max_f"),
        ),
        action=RuleAction(target="plug-cooler", state="off"),
        cooldown_seconds=60,
        log_to_session=False,
    ),
    "Dehumidify Cutoff": AutomationRule(
        name="Dehumidify Cutoff",
        description="Stop the dehumidifier once humidity is back within range",
        priority=10,
        applies_to_phases=list(_OPEN_SUBSTRATE_PHASES),
        condition=RuleCondition(
            type=ConditionType.THRESHOLD,
            threshold=ThresholdCondition(sensor="humidity", operator="lt", profile_ref="humidity_max"),
        ),
        action=RuleAction(target="plug-dehumidifier", state="off"),
        cooldown_seconds=60,
        log_to_session=False,
    ),
}


def _superseded_builtin_rules() -> dict[str, tuple[AutomationRule, ...]]:
    forms: dict[str, list[AutomationRule]] = {}
    for table in (LEGACY_BUILTIN_RULES, PRE_BROWNING_BUILTIN_RULES,
                  PRE_FULL_SCALE_BUILTIN_RULES, PRE_DARK_REST_BUILTIN_RULES,
                  PRE_PHASE_GATE_BUILTIN_RULES, PRE_DEADBAND_BUILTIN_RULES):
        for name, rule in table.items():
            forms.setdefault(name, []).append(rule)
    return {name: tuple(rules) for name, rules in forms.items()}


# Every superseded shipped form of each built-in, by name — a rule can have been
# changed more than once (Dehumidify Cutoff: the event-spamming form, then the
# pre-browning gate). seed_builtin_rules upgrades an unedited copy of ANY of
# them to the current BUILTIN_RULES entry.
SUPERSEDED_BUILTIN_RULES: dict[str, tuple[AutomationRule, ...]] = _superseded_builtin_rules()


# Built-ins no release ships any more, exactly as they last shipped. Removing
# a built-in from BUILTIN_RULES leaves every stored copy running, so it is
# recorded here instead: seed_builtin_rules switches an unedited copy off,
# once (an operator can switch it back on), and names an edited one in the log.
# Light Scene — Fruiting re-lit the fruiting scene every hour, through the dark
# period Photoperiod — Lights Off keeps. The two CO2 restrict rules became CO2
# Floor — Restrict FAE, which reads the profile's co2_min_ppm instead (reishi
# conk sessions no longer have their FAE held off).
RETIRED_BUILTIN_RULES: dict[str, AutomationRule] = {
    "Light Scene — Fruiting": AutomationRule(
        name="Light Scene — Fruiting",
        description="Switch to fruiting light scene when entering fruiting phase",
        priority=3,
        applies_to_phases=["fruiting"],
        condition=RuleCondition(
            type=ConditionType.SCHEDULE,
            schedule=ScheduleCondition(interval_min=60),
        ),
        action=RuleAction(target="light-01", scene="fruiting_standard"),
        cooldown_seconds=3600,
        log_to_session=True,
    ),
    "Reishi Antler CO2 Restrict FAE": AutomationRule(
        name="Reishi Antler CO2 Restrict FAE",
        description="Keep FAE minimal during reishi antler formation to maintain high CO2 >1500ppm",
        priority=12,
        applies_to_species=["reishi"],
        applies_to_phases=["primordia_induction"],
        condition=RuleCondition(
            type=ConditionType.THRESHOLD,
            threshold=ThresholdCondition(sensor="co2_ppm", operator="lt", value=1500),
        ),
        action=RuleAction(target="relay-01", channel="fae", state="off"),
        cooldown_seconds=300,
        log_to_session=True,
    ),
    "King Trumpet Primordia CO2 Restrict": AutomationRule(
        name="King Trumpet Primordia CO2 Restrict",
        description="Restrict FAE during king trumpet primordia to keep CO2 elevated (1000-2000ppm)",
        priority=12,
        applies_to_species=["king_trumpet"],
        applies_to_phases=["primordia_induction"],
        condition=RuleCondition(
            type=ConditionType.THRESHOLD,
            threshold=ThresholdCondition(sensor="co2_ppm", operator="lt", value=1000),
        ),
        action=RuleAction(target="relay-01", channel="fae", state="off"),
        cooldown_seconds=300,
        log_to_session=True,
    ),
}


# What a fresh table was seeded with before 5.2.0, by name in seed order.
# Those releases seeded only an empty table and recorded nothing, so on such a
# database seed_builtin_rules has to work out from what is stored which
# built-ins the Pi was already given (an absent one may have been deleted).
# Every release from 0.2 to 4.x seeded the first set; 5.0.0 to 5.1.x the second.
SEEDED_BEFORE_V5: tuple[str, ...] = (
    "Humidity Boost", "Humidity Cut", "CO2 FAE Trigger", "Emergency CO2 Exhaust",
    "Scheduled FAE Cycle", "Heating Trigger", "Cooling Trigger", "Heating Cutoff",
    "Cooling Cutoff", "Light Scene — Fruiting", "Light Scene — Colonization Dark",
    "Lion's Mane Night Cool", "Reishi Antler CO2 Restrict FAE",
    "King Trumpet Primordia CO2 Restrict", "Cordyceps Blue Light",
    "Pre-cool for Hot Forecast", "Dry Weather Humidity Boost", "Heat Wave Warning",
)
SEEDED_V5_0_TO_V5_1: tuple[str, ...] = (
    "Humidity Boost", "Humidity Cut", "Dehumidify", "Dehumidify Cutoff",
    "Humidity Vent (no dehumidifier)", "Circulation Cycle", "Mist (no humidifier)",
    "CO2 FAE Trigger", "Emergency CO2 Exhaust", "CO2 Hard Ceiling",
    "Scheduled FAE Cycle", "Heating Trigger", "Cooling Trigger", "Heating Cutoff",
    "Cooling Cutoff", "Photoperiod — Lights On", "Photoperiod — Lights Off",
    "Light Scene — Colonization Dark", "Lion's Mane Night Cool",
    "CO2 Floor — Restrict FAE", "Cordyceps Blue Light", "Pre-cool for Hot Forecast",
    "Dry Weather Humidity Boost", "Heat Wave Warning",
)
