59psi/SporePrint/server/app/automation/models.py

import time
from enum import Enum
from typing import Any

from pydantic import BaseModel, model_validator


class ConditionType(str, Enum):
    THRESHOLD = "threshold"
    SCHEDULE = "schedule"
    COMPOUND = "compound"


class CompoundOp(str, Enum):
    AND = "AND"
    OR = "OR"


class ThresholdCondition(BaseModel):
    sensor: str  # "temp_f", "humidity", "co2_ppm", "lux"
    operator: str  # "lt", "gt", "lte", "gte", "eq"
    value: float | None = None  # absolute value
    profile_ref: str | None = None  # e.g. "humidity_min", "co2_max_ppm", "temp_max_f"


class ScheduleCondition(BaseModel):
    """When a rule is allowed to fire.

    ``photoperiod`` and ``profile_interval_ref`` make the SCHEDULE itself
    species-driven, the way ``ThresholdCondition.profile_ref`` already does for
    setpoints. The grow profile states how many hours of light a phase wants and
    how often it wants fresh air; those numbers should drive the schedule rather
    than be duplicated as literals in a rule that then ignores the species.
    """

    cron: str | None = None  # 5-field cron, e.g. "*/20 * * * *"
    interval_min: int | None = None  # every N minutes since this rule last fired
    time_range: tuple[str, str] | None = None  # ("22:00", "06:00") for night

    # Species-driven light cycle. "on" matches while the current phase's light
    # window is open, "off" while it is closed. The window length is the
    # profile's light_hours_on — so a 12/12 species gets a real 12/12 cycle, and
    # a dark colonization phase (light_hours_on = 0) never opens it at all.
    photoperiod: str | None = None  # "on" | "off"
    photoperiod_start: str = "06:00"  # local clock time the light window opens

    # Species-driven period: names a PhaseParams field holding minutes
    # (e.g. "fae_interval_min"). Takes precedence over interval_min.
    profile_interval_ref: str | None = None


class CompoundCondition(BaseModel):
    op: CompoundOp
    conditions: list["RuleCondition"]


class RuleCondition(BaseModel):
    type: ConditionType
    threshold: ThresholdCondition | None = None
    schedule: ScheduleCondition | None = None
    compound: CompoundCondition | None = None


class RuleAction(BaseModel):
    """Action a rule fires when its condition matches.

    Two action types share the same model so v3.x rules keep working:

    - **Native (default):** ``target`` is a node_id or smart_plug_id;
      the engine publishes ``sporeprint/{target}/cmd/{channel}`` with
      ``state``, ``pwm``, ``duration_sec``, etc. (existing v3.x shape).

    - **Vendor (v4.1.4):** set ``vendor_slug`` to a registered
      integration (``wemo``, ``kasa``, ``tapo``, ``fluence``, …) and
      ``vendor_action`` to one of that vendor's writable actions
      (``set_power``, ``set_dim``, ``set_setpoint``, …). Engine
      forwards ``vendor_params`` as kwargs to the integrations
      dispatcher. ``target`` then names the rule's manual-override key
      (typically ``vendor:{slug}:{ip-or-id}``).
    """

    target: str  # node_id, smart_plug_id, or vendor:* override key
    channel: str | None = None  # relay channel name (native action type)
    state: str = "on"  # "on" | "off"
    pwm: int | None = None  # 0-255 for relay, 0-1023 for lighting
    duration_sec: int | None = None
    ramp_sec: int | None = None
    scene: str | None = None  # for lighting node

    # Species-driven duration: names a PhaseParams field holding seconds
    # (e.g. "fae_duration_sec"). Resolved at fire time; overrides duration_sec.
    duration_profile_ref: str | None = None

    # v4.1.4 — vendor write-action escape hatch. When set, the engine
    # routes through `app.integrations._actions.dispatch` instead of
    # MQTT. `vendor_slug` MUST be a registered integration; the
    # dispatcher rejects unknown slugs with a clear 404.
    vendor_slug: str | None = None
    vendor_action: str | None = None
    vendor_params: dict[str, Any] = {}


class AutomationRule(BaseModel):
    id: int | None = None
    name: str
    description: str = ""
    enabled: bool = True
    priority: int = 0
    applies_to_phases: list[str] | None = None  # None = all phases
    applies_to_species: list[str] | None = None  # None = all species
    # Capability-aware fallback: fire this rule ONLY IF the named target is NOT
    # present on this chamber. It's how "vent with the fans when there's no
    # dehumidifier" degrades gracefully — the fan-evacuation rule sets this to
    # the dehumidifier plug, so it goes silent the moment a real dehumidifier is
    # paired, and the two never fight over the same excess-humidity event.
    requires_absent_target: str | None = None
    condition: RuleCondition
    action: RuleAction
    cooldown_seconds: int = 60
    safety_max_on_seconds: int | None = None
    notification: bool = False
    log_to_session: bool = True


# A locked override pins an actuator OUT of automation's reach. Left open-ended
# it silently disables climate control on that channel until someone remembers
# to clear it — a forgotten "hold" becomes a dead heater or an un-vented chamber
# for a live grow. So every override carries a hard server-side TTL ceiling:
# a null ("until cancelled") or any longer-than-ceiling request is clamped down
# to now + this. An operator who genuinely needs longer re-applies the hold —
# a deliberate, logged act, not an indefinite silent one.
MAX_OVERRIDE_TTL_SECONDS = 24 * 60 * 60  # 24h — covers any maintenance window


class ManualOverride(BaseModel):
    target: str
    channel: str | None = None
    locked: bool = True
    reason: str = ""
    expires_at: float | None = None  # unix ts; clamped to now + MAX_OVERRIDE_TTL_SECONDS

    @model_validator(mode="after")
    def _clamp_expiry(self) -> "ManualOverride":
        # Runs on every construction (unlike a field_validator, which pydantic
        # skips for a defaulted None — the exact sticky-forever case we close).
        # A null or over-long expiry is pulled back to the ceiling; a past
        # expiry is left alone (it just reads as already-expired, which several
        # override paths rely on).
        ceiling = time.time() + MAX_OVERRIDE_TTL_SECONDS
        if self.expires_at is None or self.expires_at > ceiling:
            self.expires_at = ceiling
        return self


class RuleFiring(BaseModel):
    rule_id: int
    rule_name: str
    timestamp: float
    condition_met: str
    action_taken: str
    session_id: int | None = None
