59psi/SporePrint/(commit log)

2026-04-05 Initial release: SporePrint automated mushroom cultivation system
    Full-stack scaffold with ESP32 firmware, FastAPI backend, React frontend,
    and Docker Compose deployment. Includes 94 passing tests, setup script,
    species profile library (10+ species), declarative automation engine,
    dual vision pipeline (local CNN + Claude API), and AGPL-3.0 license.
2026-04-05 Fix UI port to 3001, add npm check script, fix eslint purity error
    - Change UI port from 3000 to 3001 in docker-compose, vite config, README, setup.sh
    - Add `npm run check` script (tsc -b + vitest + eslint) for full verification
    - Fix React purity lint error: move Date.now() from render scope into
    TelemetryChart useEffect via rangeSeconds prop
    - Update README dev commands to use proper build verification
2026-04-05 Fix python-socketio ASGIApp init for v5.11+
    The `other_app` keyword was removed in recent versions.
    Use positional argument instead.
2026-04-05 Add integration tests: API smoke tests + Docker compose validation
    - test_api.py (14 tests): Full HTTP stack tests via FastAPI TestClient
    covering health, sessions lifecycle, species, automation rules,
    telemetry ingest/query, vision, hardware, and transcript export.
    Would have caught the socketio startup crash.
    - test_docker.py (5 tests): Validates docker-compose.yml structure,
    image names, env var prefixes, and port mappings. Would have caught
    the binsr/ntfy typo.
    - conftest.py: Add client fixture with mocked MQTT for integration tests.
    Total: 93 backend + 20 frontend = 113 tests.
    [test_api.py, test_docker.py]
2026-04-05 Fix Sidebar branding to SporePrint, expand species library to 23 profiles
    - Fix split-span "Myco/Core" → "Spore/Print" in Sidebar.tsx (missed by
    replace_all since it was split across an HTML tag)
    - Add 12 new species profiles:
    Active: Tidal Wave, Blue Meanie (Pan Cyan), Natal Super Strength
    Gourmet: Yellow Oyster, Chestnut, Pioppino, Nameko, Enoki, Wood Ear
    Medicinal: Maitake, Chaga, Meshima
2026-04-05 Add location fields (tub/shelf/side), expand to 31 species profiles
    Location:
    - Add tub_number, shelf_number, shelf_side to sessions DB schema,
    Pydantic models, service layer, session wizard UI, and detail view
    - Location shows as "Tub 1 Shelf 2 left" in session header
    Species (31 total, up from 23):
    Active (8): +Tidal Wave, Pan Cyan, Natal SS, P. tampanensis, P. mexicana
    Gourmet (17): +Pearl Oyster, Phoenix Oyster, White Beech, Button/Cremini/
    Portobello, Wine Cap, Almond Mushroom
    Medicinal (6): unchanged
2026-04-05 Add weather-aware automation: outdoor conditions drive grow decisions
    New weather module polls OpenWeatherMap and injects outdoor conditions
    as virtual sensors into the automation engine. Rules can reference
    outdoor_temp_f, outdoor_humidity, forecast_high_f, forecast_low_f
    exactly like physical sensor readings — zero engine changes needed.
    Backend:
    - server/app/weather/ — service (polling, caching, OWM API), router
    (GET /current, /forecast, /history)
    - weather_readings DB table for historical outdoor conditions
    - mqtt.py enriches telemetry readings with weather before evaluate_rules()
    - 3 built-in weather rules: pre-cool for hot forecast (>90°F),
    dry weather humidity boost (<25% ou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
2026-04-05 Add predictive weather intelligence: multi-provider, retention, learning
    Weather Providers (3 options):
    - Open-Meteo (default, free, no API key needed — just lat/lon)
    - OpenWeatherMap (requires key)
    - NWS (US-only, free, no key)
    All return 7-day hourly forecasts via common provider interface.
    Tiered Data Retention (~120 MB/year on RPi):
    - Raw telemetry: 7 days
    - 5-min averages: 30 days
    - Hourly averages: 365 days
    - Daily averages: forever
    Nightly cron task at 3 AM compresses old data + VACUUM.
    Predictive Model (weather→closet correlation):
    - Linear regression: predicted_indoor_temp = f(outdoor_temp, humidity, hour)
    - Retrains daily at 4 AM from last 30 days of correlated data
    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
2026-04-05 Replace Builder with 3-tier hardware integration guide
    Replaces the Claude-chat-only Builder with concrete, pre-built hardware
    setup guides at 3 price points:
    Bare Bones (~$100): ESP32 + SHT31 + BH1750 + Shelly plug.
    Monitor temp/humidity/light, manual humidifier control.
    Recommended (~$200): Full system — climate node (SHT31 + SCD40 + BH1750),
    relay node (4ch MOSFET fan control), lighting node (white + blue LEDs),
    ESP32-CAM vision, 2 smart plugs. Full automation.
    All the Things (~$350+): Everything above + redundant sensors, 4-spectrum
    LED (white/blue/red/far-red), 4 smart plugs, 2 cameras, load cell,
    door sensor, peristaltic pump for automated misting.
    Each tier includes:
    -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
    [hardware_guides.py, models.py, router.py]
2026-04-05 Add color-coded SVG wiring diagrams to Hardware Builder
    Replaces ASCII wiring diagrams with interactive SVG graphics:
    - Climate Node: ESP32 → SHT31/SCD40/BH1750 with color-coded I2C bus
    (blue=SDA, green=SCL, red=3.3V, grey=GND), shared bus shown as
    dashed lines, I2C addresses labeled per sensor
    - Relay Node: 4-channel MOSFET fan control diagram showing
    GPIO→100R→IRLZ44N→fan path with flyback diodes and pull-downs
    - Lighting Node: 4-spectrum LED PWM diagram with color-matched
    strips (white/blue/red/far-red) and IRLZ44N switching
    - Camera Node: ESP32-CAM ↔ USB-UART programmer wiring with
    TX/RX crossover labels
    Legend shows wire color coding. Tier 3 adds notes for extra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
2026-04-05 Simplify: fix inline imports, extract shared helpers, add index
    Code reuse:
    - Extract get_active_session() to sessions/service.py — was duplicated
    in automation/engine.py and weather/service.py (and inlined in
    weather/router.py). All 3 now use the shared function.
    Import violations (CLAUDE.md convention):
    - Move 11 inline imports to module top: weather/service.py (4),
    weather/providers.py (2), weather/router.py (4), main.py (1)
    Efficiency:
    - Add compound index idx_telemetry_sensor_time(sensor, timestamp) for
    prediction training query
    - Rewrite prediction JOIN from ABS() to BETWEEN (allows index use)
    [engine.py, router.py, service.py]
2026-04-05 Release v0.2.0: update all docs, version strings, and config
    Version bumped to 0.2.0 in:
    - server/pyproject.toml
    - server/app/main.py (FastAPI title + health endpoint)
    - ui/package.json
    - ui/src/components/layout/Sidebar.tsx
    README.md — comprehensive rewrite:
    - 40 species profiles (was "10+")
    - Weather-predictive intelligence (3 providers, 7-day forecast, 72h alerts)
    - Data retention (~120 MB/year tiered compression)
    - 3-tier hardware builder with SVG wiring diagrams
    - Session location fields (tub/shelf/side)
    - Full config table with all 12 SPOREPRINT_ variables
    - Updated project structure with weather/, retention/, tests/
    CLAUDE.md — updated:
    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
2026-04-06 Add cloud connector + system health endpoints for mobile app
    Cloud connector (server/app/cloud/):
    - Persistent WebSocket connection to upstream cloud relay
    - Opt-in: inactive unless SPOREPRINT_CLOUD_URL + _TOKEN configured
    - Queues telemetry during disconnects, drains on reconnect
    - Receives remote commands with tier validation (premium = control, free = rejected)
    - Exponential backoff reconnection (5s → 300s)
    - GET /api/cloud/status, POST /api/cloud/reconnect
    System health endpoints (server/app/health/):
    - GET /api/health/detail/system — CPU%, memory%, disk%, temp, uptime, DB size
    - GET /api/health/detail/mqtt — broker stats from $SYS/# topics
    - GET /api/health/detail/clients — Soc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
    [router.py, service.py, test_cloud.py, test_health.py]
2026-04-07 v0.2.1: update docs for cloud connector + mobile app support
    Version bumped to 0.2.1 in: pyproject.toml, main.py, package.json, Sidebar.tsx
    README.md:
    - Added cloud/ and health/ to project structure
    - Added SPOREPRINT_CLOUD_URL, _TOKEN, _DEVICE_ID to config table
    - Added Cloud Connector and System Health to features list
    - Updated test count to 131 backend
    CLAUDE.md:
    - Added cloud/ and health/ to directory structure tree
    AGENTS.md:
    - Added cloud connector + health metrics to backend-agent constraints
    .env.example:
    - Added cloud connector env vars section
2026-04-08 Fix unicode escapes: use literal ° and · characters
    Vite alias resolution from external projects doesn't process JS unicode
    escapes (\u00b0, \u00b7) in string literals — they render as raw text.
    Replace with actual UTF-8 characters throughout the UI.
2026-04-08 Add health heartbeat to cloud connector
    Pi now pushes system metrics (CPU/RAM/disk/temp, cloud connection
    health, queue depth) to the cloud relay every 60 seconds via a
    'device_health' Socket.IO event. This lets the mobile app see Pi
    health remotely without needing direct LAN access.
    Heartbeat starts on cloud connect, cancels on disconnect.
2026-04-08 Sprint 2: Add device pairing code generation + Pi settings UI
    Pi-side pairing flow:
    - POST /api/cloud/pairing-code — generates 6-digit code, valid 10 min
    - GET /api/cloud/pairing-code — returns active code + remaining time
    - POST /api/cloud/pair — validates code, returns device info, one-time use
    Settings page:
    - New "Mobile App Pairing" section with generate button
    - Shows large monospace code with copy button + countdown timer
    - Code auto-expires and UI resets
    [router.py]
2026-04-08 Bump version to 0.3.0
    Sprint 2 release: device pairing, health heartbeat, unicode fixes.
    [test_api.py]
2026-04-08 Complete Sprint 2: cloud configure endpoint for pairing token writeback
    POST /api/cloud/configure — receives cloud credentials from mobile app
    after pairing, writes SPOREPRINT_CLOUD_DEVICE_ID and _TOKEN to .env
    so the Pi can connect to the cloud relay on next restart.
2026-04-13 feat: v1.9.0 — per-component health reporting, cloud forwarding, Golden Teacher→Blue Oyster
2026-04-14 feat: add 5 new tables — weather_history, cultures, chambers, experiments, drying_log
2026-04-14 feat: seasonal grow planner — species recommendations, calendar, session warnings
2026-04-14 feat: contamination library — 7 contaminant profiles + Claude Vision identification
2026-04-14 feat: culture/spawn tracking — lineage trees, spore prints, tissue clones, contamination rates
2026-04-14 feat: multi-chamber management + experiment mode (A/B testing)
2026-04-14 feat: 7 new frontend pages — planner, wizard, contamination, cultures, chambers, experiments, shopping
2026-04-14 fix: PDF reports (vision+contam+recommendations), shopping supplier links, species photo references
    [models.py, service.py]
2026-04-14 fix: chamber comparison, experiment AI analysis, QR Bluetooth print
    [router.py, service.py, test_chambers.py, test_experiments.py]
2026-04-14 fix: 6 completeness gaps — drying notification, calendar predictions, chamber selection, supplier URLs, contam photos, experiment auto-report
    [models.py, service.py]
2026-04-15 feat: unit preferences — °F/°C and g/oz toggles with display conversion
2026-04-15 fix: session wizard chamber step — uncommitted UI changes
2026-04-15 docs: update CLAUDE.md and README.md for v3.0 — 6 new modules, 5 new tables, 7 new pages
2026-04-15 fix: remediate Semgrep findings — eliminate SQL concatenation, remove credential-adjacent log words
    [service.py]
2026-04-15 refactor: simplify review — SQL aggregates, recursive CTE, batch iCal, TTL cleanup, import hygiene
2026-04-15 docs: architecture SVG diagrams — system overview, data flow, dual-repo, cloud relay
2026-04-15 security: vision upload validation — size limit + content-type check
2026-04-15 fix: haptic feedback on session wizard step transitions
    Add light haptic on wizard next/back step navigation and settings
    unit toggles. New haptics.ts utility uses dynamic Capacitor imports
    (safe no-op on web).
2026-04-15 security: update Vite 8.0.x → 8.0.5 — fix path traversal + fs.deny bypass + WebSocket file read (GHSA-4w7w-66w2-5vf9, GHSA-v2wj-q39q-566r, GHSA-p9ff-h696-f583)
2026-04-15 fix: schema migration — add missing columns to existing databases (provider, chamber_id)
2026-04-15 fix: replace all active species (Golden Teacher) with gourmet (Blue Oyster) in test data and defaults
    [test_api.py, test_calendar.py, test_chambers.py, test_cultures.py, test_drying.py, test_experiments.py, test_pdf_report.py, test_planner.py]
2026-04-15 fix: bump submodule version 0.3.0 → 3.0.0 (package.json, FastAPI, sidebar, health test)
    [test_api.py]
2026-04-15 fix: Docker — add matplotlib dependency, pin Python 3.12, non-root user, version bump script
2026-04-15 fix: Dockerfiles — pin Python 3.12.12, Node 22, upgrade pip, npm ci, suppress root warnings
2026-04-15 fix: hardware guides — current-gen components (Pi 5, ESP32-S3, SCD41, Shelly Plus), stable URLs
    [hardware_guides.py, service.py]
2026-04-16 release: v3.0.1 — hardware guide updates, Docker fixes, schema migration, species cleanup
    [test_api.py]
2026-04-16 release: v3.0.2 — synced with parent v3.0.3
2026-04-16 fix: Dockerfile — suppress adduser prompts (--gecos) and pip root warning
    [test_api.py]
2026-04-16 release: v3.0.4 — synced with parent
2026-04-16 perf: code splitting — lazy-load 14 pages, core bundle 781KB→286KB; suppress npm upgrade notice in Docker
2026-04-16 release: v3.0.6 — synced with parent
2026-04-16 fix: hardware BOM — Amazon search URLs (no single-vendor), OpenSCAD 3D print models
    - SCD41: replace Adafruit product link with Amazon search URL (Adafruit
    24-week lead time). Add Adafruit/SparkFun as alternates in notes. Add
    MH-Z19B as budget alternative (~$15, UART, 0-5000ppm).
    - All component primary links are now Amazon search URLs (aggregator,
    multiple sellers) — no single-vendor links that go out of stock.
    - New models/ directory with 4 parametric OpenSCAD files:
    sensor_mount.scad (SHT31+BH1750 enclosure with ventilation + snap lid)
    esp32_case.scad (ESP32 DevKit case with USB cutout + mount tabs)
    cam_mount.scad (ESP32-CAM adjustable pivot mount + friction washers)
    rel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
    [cam_mount.scad, esp32_case.scad, relay_board_mount.scad, sensor_mount.scad]
2026-04-16 fix: hardware BOM — verified in-stock components (Athom Tasmota replaces OOS Shelly, SCD41 sourcing fixed)
    - Replace Shelly Plus Plug S ($22, OOS) with Athom Tasmota Smart Plug ($10, in stock)
    - Update setup steps with Tasmota AP configuration flow
    - Fix SCD41 URL to Amazon search, add Pimoroni/Newark sources, flag Adafruit backorder
    - Update ESP32-S3 CAM notes with Seeed Studio/Walmart availability
    - Raspberry Pi 5 price updated $60 → $75
    - Tier estimated costs adjusted for plug savings
    [hardware_guides.py, test_api.py]
2026-04-16 release: v3.0.9 — synced with parent
2026-04-16 feat: Species page overhaul — disclaimers, TEK guides, recipes, photos, novelty category
2026-04-16 feat: weather multi-provider failover — cascade through Open-Meteo, NWS, OpenWeatherMap
    Replace single-provider weather fetch with cascading failover that tries
    all available providers in order until one succeeds. If Open-Meteo is
    down, NWS is tried next, then OpenWeatherMap (if API key configured).
    Current and forecast fetches fail over independently.
    [service.py, test_api.py]
2026-04-16 feat: OpenSCAD API, standalone build steps, 4 new 3D models
    Add /api/builder/models endpoints to list and download .scad files.
    Make Tier 2 and Tier 3 setup_steps fully self-contained (no cross-tier
    references). Add pi_case, fan_duct, power_supply_mount, sensor_bracket
    OpenSCAD models.
    [fan_duct.scad, pi_case.scad, power_supply_mount.scad, sensor_bracket.scad]
2026-04-16 fix: bump script — escape dots in sed regex to prevent mangling test comments
    [test_api.py]
2026-04-16 release: v3.0.12 — Species overhaul, weather failover, OpenSCAD API, standalone build steps
    [test_api.py]
2026-04-16 fix: OpenSCAD models — Docker volume mount + fallback path detection
    [models_router.py]
2026-04-16 release: v3.0.13 — all quality sprint fixes verified in Docker
    [test_api.py]
2026-04-16 release: v3.0.14 — synced with parent
2026-04-16 fix: hardware BOM — multiple vendor links for all 28 components
    [hardware_guides.py]
2026-04-16 release: v3.0.15 — multi-vendor links for all 28 hardware components
2026-04-16 release: v3.0.16 — synced with parent
2026-04-16 feat: OpenSCAD zip tie + suction cup mounts, sensor placement guide in build steps
    All 8 3D print models now include real-world mounting options beyond
    M3 screw holes: zip tie slots for shelf/wire/rail attachment and suction
    cup mounts for glass/smooth surfaces. Each file has a standardized
    comment header documenting mounting options and print settings.
    Hardware guides setup_steps now include inline sensor placement guidance
    for all three tiers — where to place climate sensors (substrate level,
    not ceiling), relay boards (outside chamber), cameras (front-facing vs
    top-down), and smart plugs (accessible outlets, what plugs into them).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
    [cam_mount.scad, esp32_case.scad, fan_duct.scad, pi_case.scad, power_supply_mount.scad, relay_board_mount.scad, sensor_bracket.scad, sensor_mount.scad]
2026-04-16 release: v3.0.17 — inline photos, Builder 3D downloads, zip tie/suction cup mounts, sensor placement guides
2026-04-16 release: v3.0.18 — synced with parent
2026-04-16 feat: user-configurable settings from UI — weather lat/lon, provider, API keys, no .env editing needed
2026-04-16 release: v3.0.20 — synced with parent
2026-04-16 fix: weather polling waits for lat/lon config from Settings UI instead of exiting on empty
    [service.py, test_api.py]
2026-04-16 feat: SVG wiring diagrams for all 3 hardware tiers + overall system
    Replace ASCII art in hardware_guides.py with proper SVG diagrams that
    use color-coded wires (emerald=signal, blue=I2C, amber=power, red=GND),
    component boxes, pin labels, and legends matching existing doc SVG style.
    [hardware_guides.py]
2026-04-16 feat: SVG wiring diagrams for all 3 hardware tiers + overall system diagram
2026-04-16 feat: SVG diagrams served via API + displayed on Builder page, docs volume mount in Docker
2026-04-16 release: v3.0.24 — synced with parent
2026-04-16 feat: rewrite tier 2, tier 3, overall SVG wiring diagrams — detailed MOSFET circuits, no overlaps
2026-04-16 feat: complete SVG wiring diagram rewrite — detailed MOSFET circuits, pin-level connections, step-by-step instructions
2026-04-16 docs: comprehensive .md update for v3.0.25
    - Species counts: 19 active, 24 gourmet, 7 medicinal, 5 novelty (55 total)
    - SQLite tables: 25 -> 26 (added user_settings)
    - Router groups: 16 -> 17 (added settings)
    - Added: weather multi-provider failover, Settings UI, novelty category
    - Added: 8 OpenSCAD models, 8 SVG diagrams in feature lists
    - Updated AGENTS.md with current counts
2026-04-16 refactor: simplify — TTL cache for file listings, provider timeouts, error handling, remove noise comments
    [models_router.py, service.py]
2026-04-16 fix: rewrite all 4 wiring SVGs — larger layouts, 20px text spacing, dark label backgrounds, no overlaps
    - Tier 1: 900x700 viewBox (was 800x600), Pi/plug as separate callouts, dark pill labels on all wires
    - Tier 2: 1400x1000 viewBox (was 1200x900), 4 quadrants with 80px gutters, full MOSFET circuit detail for CH0
    - Tier 3: 1600x1200 viewBox (was 1400x1000), purple-bordered NEW IN TIER 3 boxes, references Tier 2 for circuits
    - Overall: 1000x700 viewBox (was 1000x600), clean semicircle layout, no pin/resistor detail
    - All: minimum 20px between independent text elements, dark background rects behind wire labels, 16px line height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
2026-04-16 fix: rewrite all 4 wiring SVGs — larger viewboxes, 20px text spacing, dark label backgrounds, zero overlaps
    [test_api.py]
2026-04-16 release: v3.0.28 — synced with parent
2026-04-16 fix: tier3 SVG XML parse error (double-dashes in comments)
    [test_api.py]
2026-04-16 release: v3.0.30 — synced with parent v3.0.13
2026-04-16 perf: replace PDF reports with CSV + Markdown — removes matplotlib/numpy, Docker image 676MB→349MB, saves ~50MB RAM on Pi
    [router.py, service.py, test_api.py, test_pdf_report.py]
2026-04-16 release: v3.0.14 — Stripe subscription portal, CSV+MD reports, cloud PDF→MD export
2026-04-16 release: v3.0.15 — synced
2026-04-16 perf: lazy-load icalendar + anthropic — faster Pi startup, less idle RAM
2026-04-16 release: v3.0.35 — synced
2026-04-16 release: v3.0.36 — synced
2026-04-16 release: v3.0.37 — launch readiness sprint (welcome card, legal, security)
2026-04-16 release: v3.0.38 — synced
2026-04-16 release: v3.0.39 — synced
2026-04-17 fix: ESP32 case — update dimensions from ESP32-WROOM (28x52mm) to ESP32-S3-DevKitC-1 (25.5x70mm, USB-C)
    [esp32_case.scad]
2026-04-17 chore: refresh BOM links, prices, and diagram labels
    Hardware audit findings:
    - SCD41 CO2: swap primary URL Amazon→Pimoroni (Pimoroni has reliable stock; Adafruit 5190 still backordered); price $45→$46
    - ESP32-S3 CAM: switch primary to Freenove ESP32-S3 WROOM CAM (OV2640, $20) with specific Amazon ASIN; mark OV5640 as premium upgrade path (XIAO + add-on or Waveshare)
    - Peristaltic pump: fix price $12→$25 (Adafruit 1150 is $24.95); primary URL now direct to Adafruit
    - Noctua NF-A8: switch primary to 12V PWM ($17, standard); 5V variant kept as note ($26)
    - Far-red 730nm LED: swap Amazon search→superlightingled.com (Amazon returns fixtures, not strips); price $12→$18; add fallback not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
    [hardware_guides.py, test_api.py]
2026-04-17 feat(builder): detailed tier capabilities + collapsible page sections
    - Added CapabilityGroup model + HardwareTier fields: best_for, species_support, capability_groups, limitations
    - Each tier now documents who it's for, species coverage, grouped capabilities (monitoring, automation, lighting, vision, etc.), and honest limitations
    - /builder/tiers endpoint returns the new fields
    Frontend (Builder.tsx):
    - New "Capabilities" tab (default) renders best-for context, species coverage, grouped capability cards, and limitations panel
    - Reorganized tabs: Capabilities | Shopping | Wiring | Setup
    - Extracted Collapsible component — 3D Print Models, Wiring Diagrams, and Assistant are now co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
2026-04-17 design: organic dark redesign — tokens, sensor card, status pill, sparkline, spore mark
    Brand direction: warm organic dark, bioluminescent teal primary, warm amber
    secondary, mycelium white text on substrate charcoal. Not cyberpunk, not
    cold-clinical — a high-end lab instrument aesthetic.
    New design tokens (index.css):
    - Warm palette: #0d0e0c substrate, #e8e4db mycelium white (7:1 on base),
    #3dd68c bioluminescent teal primary, #d9a441 amber secondary, #d95c41 warm danger
    - Layered radii, alpha-based hairline borders (no hard #2e3346 edges)
    - Inter var (ligatures + ss01/cv11) + JetBrains Mono for all numerics
    - Radial ambient + SVG noise grain overlays, both at ~2.5-3.5% opacity
    - Lega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
    [test_api.py]
2026-04-17 release: v3.1.0 — organic dark redesign propagated across all surfaces
    - server/pyproject.toml drifted at 3.0.0 — now synced to 3.1.0
    - All submodule + UI version strings at 3.1.0
    [test_api.py]
2026-04-17 security: LAN-scoped CORS on Pi REST API (fixes Semgrep wildcard-cors finding)
    Previously the Pi FastAPI server accepted CORS from any origin, meaning any
    website the user visits could cross-origin-request their Pi to toggle fans,
    lights, smart plugs, and other device control endpoints.
    New policy: allow_origin_regex restricts to
    - localhost + 127.0.0.1 (any port)
    - *.local (mDNS, e.g. sporeprint.local)
    - RFC1918 private IPs: 10.0.0.0/8, 172.16.0.0/12, 192.168.0.0/16
    - capacitor://localhost (native mobile shell)
    Socket.IO keeps wildcard origin with explanatory comment — engineio's CORS
    has no regex support and the Pi's LAN IP varies per household. Risk is
    contained: Socket.IO onl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
    [test_api.py]
2026-04-17 v3.1.2: Pi CORS allows sporeprint.ai for pairing + cloud/configure writes
    Pi FastAPI CORS regex now admits https://sporeprint.ai so the hosted web app
    can complete the device pairing flow — POST /api/cloud/pair and POST /api/cloud/
    configure are initiated from the user's browser directly against the Pi during
    initial setup and were being blocked by the LAN-only policy introduced in v3.1.1.
    Regex anchoring verified: accepts https://sporeprint.ai exactly, rejects
    http://sporeprint.ai (no TLS), https://sporeprint.ai.evil.com, and
    https://evil.sporeprint.ai.
2026-04-17 security: revert sporeprint.ai from Pi CORS — mixed content + NAT make it unreachable
    The v3.1.2 addition of https://sporeprint.ai to the Pi's CORS regex was wrong.
    Even with CORS permitting the origin:
    1. Browsers block HTTPS→HTTP mixed content before CORS is evaluated, so a
    page at https://sporeprint.ai cannot POST to http://192.168.x.x:3001.
    2. The Pi sits behind home NAT; Railway servers cannot reach it on any
    reverse FQDN anyway.
    The REAL handshake is:
    - Pairing happens from the LAN (native mobile app or LAN-browser dev mode),
    not from the hosted web app.
    - Pi opens an OUTBOUND WebSocket to sporeprint.ai using the Supabase-generated
    device_token; cloud relays comm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
    [test_api.py]
2026-04-17 v3.1.5: critical push replaces SMS, Pi setup wrapper, firmware in builder, docs link in sidebar
    Removed:
    - Twilio SMS escalation (backend + config + status) — A2P 10DLC carrier cost
    + runaway-loop risk wasn't worth the UI work. Saved $16/mo fixed floor +
    per-user variable.
    Added:
    - scripts/setup-pi.sh — one-command Pi install (installs Docker, clones,
    seeds .env, builds + starts stack). Idempotent, documented in README
    under the new "One-command install on a Raspberry Pi" quick start.
    - Builder page now lists ESP32 firmware files grouped by node. Backend
    exposes /api/builder/firmware + /api/builder/firmware/{path} with an
    allow-listed root set (climate/relay/lighting/cam + s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
    [models_router.py, test_api.py]
2026-04-17 chore: v3.1.6 bump + stale architecture SVGs updated (Twilio → Critical Push)
2026-04-17 fix: scrub stale OV5640 labels in tier3 wiring SVG
    Two instances of 'ESP32-S3 CAM | OV5640 | USB-C 5V only' in
    wiring-tier3-all-the-things.svg were missed in the v3.0.20 BOM refresh
    (my replace_all regex failed to match 'OV5640 | USB-C 5V only' — only
    caught the 'only' variant at the end). Now consistent with tier2 and
    wiring-overall-system: 'ESP32-S3 CAM | OV2640/OV5640 | USB-C 5V'.
    All 4 wiring diagrams and 4 architecture diagrams now pass a full
    stale-term grep (Twilio, SMS, SCD40, Shelly, ESP32-WROOM, old camera
    labels). Only 'Optional BME280' remains in architecture-overview.svg,
    which is correct — firmware supports it as an add-on.
2026-04-17 chore: bump v3.1.7 — wiring + architecture diagrams fully scrubbed of stale refs
2026-04-17 fix: mount firmware/ into the server container so /api/builder/firmware returns files
    Added 'ESP32 Firmware' section in the Builder UI in v3.1.5 (Collapsible
    listing climate_node / relay_node / lighting_node / cam_node /
    sporeprint_common + platformio.ini). The backend endpoint
    /api/builder/firmware reads from /firmware inside the container, but
    docker-compose.yml never mounted it. Result: firmware array empty →
    section hidden because we only render when firmware.length > 0.
    Fix: add read-only volume mount:
    - ./firmware:/firmware:ro
    Read-only so the running server can't accidentally write to firmware
    source on the host. After a 'docker compose up -d --force-recreate server'
    the Builder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
    [test_api.py]
2026-04-17 feat(builder): per-node firmware ZIP bundles
    Added GET /api/builder/firmware/bundle/{node} that streams a complete,
    self-contained PlatformIO project as a single .zip — node source +
    shared sporeprint_common library + top-level platformio.ini + a
    generated README with the 'pio run -t upload -e <node>' flash command.
    Exposed in the Builder UI as a "ZIP" button in each node group header
    next to the file count. Individual-file downloads still work — the
    bundle is just a convenience.
    Route order matters: /firmware/bundle/{node} is declared BEFORE the
    catch-all /firmware/{path:path} so it matches first.
    Smoke-tested: climate_node.zip is 13KB / 19 entries, contains the
    node's main.cpp + hea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
2026-04-17 docs: document the ESP32 firmware ZIP flash flow
    Added the new ZIP-based flash flow to:
    - docs/user-guide.md — dedicated "Flashing ESP32 Firmware" section
    with both Option A (download ZIP from Builder page) and Option B
    (clone repo), plus the first-boot WiFi provisioning step
    - README.md — brief ESP32 Firmware subsection under Quick Start
    pointing at the Builder page's ZIP button + the pio run command
    - hardware_guides.py setup_steps — each tier's "Install PlatformIO"
    step now mentions the ZIP option as an alternative to git clone
    v3.1.10
2026-04-17 feat(builder): full-firmware + shared-library ZIP bundles
    Screenshot showed lib/sporeprint_common and the 'full firmware' option
    missing ZIP buttons. Fixed:
    - New 'full' pseudo-group at the top of the firmware list with its own
    ZIP button → /api/builder/firmware/bundle/full streams every node's
    source + sporeprint_common + platformio.ini (25 files, 21KB).
    - lib/sporeprint_common gets its own ZIP → library-only bundle for users
    with custom node firmware who only want to update the shared code.
    Includes a README explaining how to drop it into an existing tree.
    - Per-node ZIP unchanged (climate/relay/lighting/cam still bundle their
    source + shared library + platformio.ini as befo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
    [models_router.py, test_api.py]
2026-04-17 chore: bump v3.1.12 (no submodule changes — Pi side clean)
2026-04-17 chore: bump v3.1.13 (submodule bookkeeping — doc updates are in parent)
2026-04-17 chore: bump v3.1.14 (no submodule changes — app-side Pricing + Account fixes in parent)
    [test_api.py]
2026-04-17 chore: bump v3.1.16 (cloud-side: Sentry filter + test warnings + iOS bundle ID fix)
    [test_api.py]
2026-04-17 chore: bump to v3.2.0 (native iOS UX sprint companion)
    Submodule version bump to match the parent repo. The actual UX fixes live
    in sporeprint-cloud/app (auth race, splash hide timing, LaunchScreen
    constraints, auth-shell utility) — this commit just keeps the public
    submodule version aligned with the cloud repo so /docs and release notes
    reference the same numbers.
    [test_api.py]
2026-04-18 security: v3.3.0 — close 10 prognosis findings (P1–P13, DATA-3)
    Major security and data-integrity release fixing every critical finding
    from the external audit (analysis/ bundle).
    Safety & data integrity:
    - P1: Clamp firmware uptime-seconds timestamps (ts < 2020-01-01) to
    server time in mqtt.py. Prevents 1970-epoch rows on every WiFi drain.
    - P4a: Persist manual_overrides through the existing DB table so safety
    locks survive Pi reboots.
    - P4b: Reverse rule-fire ordering — write automation_firings status=
    'pending' before publish, update to 'sent'/'failed' based on real
    mqtt_publish result. Audit log no longer lies during MQTT outages.
    - P5a: Node-liveness sweeper (60s, 900s th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
    [engine.py, router.py, service.py]
2026-04-18 docs: v3.3.0 — README security section, AGENTS.md house style, CHANGELOG
    Documents the v3.3.0 security and stability changes so downstream operators
    have a single place to read about the required migration steps.
    README.md
    - New "Security" section covers the three cross-trust surfaces that got
    hardened: MQTT broker auth + ACL + loopback bind; backend bearer-token
    gate via SPOREPRINT_API_KEY; OTA password enforcement.
    - Cloud Connector section now describes the two-step pairing handshake
    (code → configure_token → configure) and the command-channel nonce +
    target allowlist.
    - Configuration env var table adds SPOREPRINT_MQTT_USERNAME,
    SPOREPRINT_MQTT_PASSWORD, SPOREPRINT_API_KE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
2026-04-18 fix: enforce safety_max_on_seconds + delete dead websocket module (P14+P11)
    Closes the last two open items from the prognosis "should-fix soon" list
    so v3.3.0 covers every P1–P15 prescription.
    P14 / R15 — safety_max_on_seconds auto-off (fire-risk closure):
    - `_fire_rule` now schedules `_safety_auto_off` as a cancellable
    asyncio.Task whenever a rule successfully publishes state='on' with
    a non-zero `safety_max_on_seconds`. The watchdog publishes OFF after
    the declared delay and writes an `automation_firings` row with
    `rule_name='safety_max_on_seconds:<original>'` so the timeout shows
    up in the audit log.
    - Watchdogs are cancelled on: subsequent OFF publish for same
    target:cha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
    [engine.py, test_safety_max_on.py]
2026-04-18 security: v3.3.1 — HMAC-sign cloud command frames (S3 full closure)
    BREAKING: requires a v3.3.1 cloud relay. Older relays send unsigned
    frames which the Pi now refuses with 'Signature check failed'.
    Full closure of the last "partial" finding from the external audit
    (sentinel S3). v3.3.0 added defense-in-depth (id-replay LRU, tier
    check, target allowlist); this release adds the cryptographic layer
    those were stand-ins for.
    How it works:
    - Cloud relay signs every `command` frame with HMAC-SHA256 over a
    canonical JSON form of the payload using the Pi's device_token as
    the key, and stamps `ts` (epoch seconds).
    - Pi's cloud/service.on_command verifies signature + replay window
    (±30s) B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
    [service.py, test_api.py, test_cloud_signing.py]
2026-04-18 docs: flow/state SVGs → Mermaid + wiring SVGs v3.3.1 refresh
    Phase A — converted 3 architecture/flow SVGs to git-diffable Mermaid
    that renders natively on GitHub, VS Code, and any markdown viewer:
    - docs/cloud-relay-flow.svg → cloud-relay-flow.md (sequence diagram
    including v3.3.1 HMAC-signing path)
    - docs/data-flow.svg → data-flow.md (four flow subgraphs with v3.3.x
    annotations: uptime-ts clamp, weighted-merge upsert, rule-fire
    ordering, safety watchdog, AsyncAnthropic, auth'd MQTT)
    - docs/dual-repo-architecture.svg → dual-repo-architecture.md
    Phase B — wiring schematics stay SVG (pin-level precision beats any
    Mermaid primitive) but now annotated with v3.3.x state:
    - Mosq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
2026-04-18 fix: v3.3.2 — Pi-side audit close-out
    Closes all Pi-affecting items from the second-pass archaeology bundle
    (analysis/00-READ-FIRST.md). All 276 Pi tests green, including 6 new
    (test_signing_golden.py + test_safety_max_on.py reboot-rehydration case).
    Pi-local alerters forward to cloud (P2):
    - engine._check_safety_thresholds, vision.analyze_frame_claude, and
    main._node_liveness_sweeper now call forward_event() alongside their
    local ntfy path. Premium mobile subscribers actually get push alerts
    on temperature / co2 / contamination / node_offline breaches.
    Safety watchdog reboot rehydration (P10):
    - New safety_watchdogs SQLite table persists each armed auto-off.
    - rehydrate_safety_wat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
    [engine.py, router.py, service.py, test_api.py, test_signing_golden.py]
2026-04-19 release: v3.3.3 — archaeology close-out (Pi side)
    Pi-side changes matching the cloud v3.3.3 archaeology sprint:
    Security
    - Socket.IO connect rate-limit (20/min/IP) + connection-origin logging.
    LAN-trust model now documented in app/auth.py header.
    - Cloud command signing module header clarifies the byte-for-byte
    duplication is deliberate; drift enforced by bump.sh fixture check.
    Behavior
    - safety_auto_off retries MQTT publish on failure (2s/4s/8s/16s/30s cap)
    before giving up; persisted watchdog row is retained on exhaustion so
    the next boot rehydrates and retries. Prior: a transient broker
    disconnect at the exact moment of firing left the actuator ON.
    - Persistent clou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
    [engine.py, router.py, service.py, test_api.py]
2026-04-19 release: v3.3.4 — Pi-side archaeology-3 close-out
    - mqtt.py — scrub full alert payload from WARNING log; log only node_id + alert kind
    - cloud/service.py — cloud_command_replay retention prune (2× replay window) on every accept
    - main.py — Socket.IO connect records request_id from auth dict for hot-path log correlation
    - relay/service.py equivalent reused via shared _request_context module
    - bump to 3.3.4
2026-04-20 release: v3.3.5 — Pi-side finishers for three deferred audit items
    - vision/service.py — new _ai_timing_span context manager emits
    structured INFO lines (ai_span op=… status=… duration_ms=…) for Pi
    operators who want Claude latency visibility without adding Sentry
    (Pi-no-Sentry remains a documented design non-goal).
    - analyze_frame_claude wraps the client.messages.create call so every
    vision roundtrip logs a consistent span line.
2026-04-20 release: v3.3.6 — version bump (lockstep with cloud v3.3.6)
    No Pi-side behavior changes. Bumped to stay in sync with the cloud release
    containing the Railway healthcheck hotfix, the iOS/Android native-boot
    unblocker, and the cloud-side consolidations queue from the v3.3.5 review.
2026-04-20 release: v3.3.7 — version bump (lockstep with cloud Railway hotfix)
    No Pi-side changes. Cloud v3.3.7 fixes the startup crashloop that has been
    silently serving v3.3.3 in production since v3.3.4.
    [test_api.py]
2026-04-20 release: v3.3.8 — version bump (lockstep with cloud fourth-archaeology close-out)
    No Pi-side behavior changes in this release. Stays in sync with the cloud
    release containing the fourth-archaeology close-out (P0/P1/P2 + 7
    security findings + uptime workflow fix).
    [test_api.py]
2026-04-21 release: v3.3.9 — version bump (lockstep with full fourth-archaeology close-out)
    No Pi-side behavior changes. Stays in sync with the cloud release closing
    every remaining medium + low + P2 item from the fourth archaeology pass.
2026-04-21 release: v3.3.10 — pair-verify endpoint + clock-skew diagnostic
    S-M-11: new GET /api/cloud/pair-verify?configure_token=... lets the cloud
    confirm a pairing session before minting a device_token. The mobile app
    no longer writes device_token into Supabase directly; the cloud's
    POST /devices/pair endpoint drives pair-verify + token generation + /configure.
    P2-10/E-2: verify_frame rejections now carry a categorized reject_reason
    (clock_skew / signature_mismatch / bad_frame) so an RTC-less Pi drifting
    out of the ±60s replay window surfaces distinctly instead of looking
    like a plain HMAC mismatch.
    [router.py, service.py, test_api.py]
2026-04-21 release: v3.4.0 — version bump (no Pi-side paygate changes)
    No functional Pi changes in v3.4. The tier pivot is cloud/mobile-only —
    the Pi software has no paygate beyond the existing AI-BYOK path. This is
    just the version bump to keep cloud + submodule in lockstep per bump.sh.
2026-04-22 docs: v3.4.0 audit pass — tier-pivot context + CHANGELOG backfill
    No code changes on the Pi side. Updates the public-facing docs + bump
    script to match the commercial repo's v3.4.0 tier clarification.
    - README: v3.4.0 banner explaining the commercial/OSS split (Pi stays
    AGPL-3.0 free; cloud becomes paid). Added v3.3.3 / v3.3.4 historical
    release notes that were previously only in the cloud repo's CHANGELOG.
    - CHANGELOG: v3.4.0 (version bump only, no Pi changes), v3.3.4 (cloud
    pair-verify endpoint + signing reject categories), v3.3.3 (clock-drift
    + chrony + replay nonce persistence).
    - scripts/bump.sh: parity with the cloud's bump.sh — README Version
    banner auto-update, CHANGEL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
2026-04-22 remove: scripts/bump.sh — unified into the parent cloud's bump script
    The parent repo's scripts/bump.sh now handles all Pi-side version
    strings, CHANGELOG skeleton insertion, README banner updates, and
    doc-drift checks inline. There's no longer any reason for this repo
    to carry a parallel bump script — see memory/feedback_unified_tooling.md
    in the parent for the rule.
    If you're an external contributor forking just the Pi OSS repo and need
    a bump script, write your own for your fork. This repo's canonical
    release flow assumes a checkout with the cloud parent.
2026-04-22 release: v3.4.1 — lockstep version bump (no Pi changes)
    Cloud-side closes every finding from its v3.4.0 deep-archaeology pass.
    Pi-side has no functional changes; version bumped to keep the signing-
    vectors fixture + release cadence aligned. HMAC signing, pair-verify,
    MQTT auth, and the bearer gate remain byte-compatible with v3.3.3+ and
    v3.4.x clouds.
    [test_api.py]
2026-04-22 fix: L-4 _configure_token multi-slot dict
    Pre-v3.4.1 Pi carried a single _configure_token global — a second
    parallel /pair would overwrite the first and invalidate it before the
    first client could /configure. Real scenario: admin testing two mobiles
    against the same Pi.
    Now keyed by token in _configure_tokens with TTL sweeps and a hard cap
    (32) so N sessions coexist and a pair-spam attacker can't blow memory.
    Burn-on-use on /configure preserves the existing "one-time use" property.
    Catches the L-4 finding from the v3.4.0 archaeology bundle.
    [router.py]
2026-04-23 release: v3.4.2 — version bump lockstep (no Pi protocol changes)
    Cloud-side v3.4.2 closes the remaining PG-tier archaeology items. Pi
    only change from v3.4.1 is the _configure_token multi-slot dict (L-4)
    that already shipped on this branch — version now matches the cloud
    release for signing-fixture parity.
    [test_api.py]
2026-04-23 release: v3.4.3 — lockstep bump (no Pi changes)
    Cloud-side v3.4.3 pinned @xmldom/xmldom via an npm override in the
    mobile app's package.json. Pi side unchanged; version bumps in lockstep
    for signing-fixture parity.
    [test_api.py]
2026-04-23 release: v3.4.4 — lockstep bump (no Pi changes)
    Cloud-side v3.4.4 is a /simplify cleanup pass over v3.4.3. Pi-side
    unchanged — version strings bumped so both repos stay in lockstep per
    memory/feedback_bump_per_commit.md.
2026-04-23 release: v3.4.5 — lockstep bump (no Pi changes)
    Cloud-side v3.4.5 is a second /simplify pass over the v3.3.10 → v3.4.4
    window (batched metric_active_alerts reads, parallel daily-summary
    fan-out, bounded caches, escalation.py routed through persistence.py,
    narrative-ID comment sweep). Pi-side unchanged — version strings
    bumped so both repos stay in lockstep per
    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
2026-04-24 release: v3.4.6 — lockstep bump (no Pi changes)
    Parent repo v3.4.6 adds scripts/sync-after-merge.sh and a bump.sh
    preflight to prevent submodule-pointer drift after GitHub's rebase/
    squash merges (which leave the parent's submodule pointer referencing
    a deleted branch-tip SHA). Pi side unchanged.
    [test_api.py]
2026-04-24 release: v3.4.7 — independent archaeology sweep
    12 fixes from an external code-review agent, spanning firmware safety,
    server concurrency, UI error visibility, ops hardening, and README docs.
    No protocol changes; mobile + cloud clients unchanged.
    Firmware (relay + climate nodes, wifi_manager):
    - FW-1 relay_node: clamp MQTT duration_sec to [1, 3600] s before computing
    offAt. Negative or huge payloads previously could wrap millis() and
    latch a relay ON indefinitely.
    - FW-2 relay_node: arm esp_task_wdt (10 s), reset each loop iteration.
    setup() already brings channels up OFF, which is the documented safe
    state on watchdog reset.
    - FW-3 wifi_manager: bound captive-portal loop with a 1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
    [engine.py, main.cpp, service.py, test_api.py]
2026-04-24 release: v3.4.8 — firmware CI hygiene (builds-clean, no pin changes)
    Pre-existing firmware build breaks surfaced when v3.4.7 verification ran
    `pio run` for the first time. platformio.ini was unpinned, and the code
    mixed Arduino-ESP32 core-2.x and core-3.x APIs so it compiled against
    neither. Now all four envs build cleanly from a fresh pio install.
    Pin:
    - firmware/platformio.ini: pin `platform = espressif32@6.13.0` (official,
    Arduino-ESP32 core 2.x) with a comment warning future readers that the
    code below is written against the 2.x APIs and a naïve bump will break
    PWM on every relay + lighting channel.
    Core-2.x API conformance:
    - firmware/src/relay_node/main.cpp: replace
    `led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
    [main.cpp, test_api.py]
2026-04-24 release: v3.4.9 — full archaeology-sweep close-out (31 fixes)
    Second agent-driven deep scan of the dual-repo (analysis/02-security.md
    + 01-diagnosis.md + specialists in the parent repo). Every Critical,
    High, Medium, Low, and operator-feedback item closed in one pass.
    No protocol breaks; nodes + Pi + cloud stay wire-compatible with v3.4.8.
    Firmware — Sentinel C-1 and below:
    - FW-HMAC (C-1): sporeprint_common/frame_verify.{h,cpp} verifies
    HMAC-SHA256 on every inbound MQTT command. Canonical-JSON matches
    the Python signing.py byte-for-byte; mbedtls is used (already in
    ESP-IDF, no new dep). Migration-period behavior warns + accepts when
    hmac_key is unprovisioned so existing fleet d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
    [main.cpp]
2026-05-02 release: v4.0.0 — archaeology sweep + OTA progress + firmware coredump/log forwarding
    Lockstep v4.0.0 release, paired with the parent cloud repo's v4.0.0 cut.
    Companion to the v3.4 → v4 migration (Next.js cloud-web shell on Railway).
    ## v4 archaeology fixes shipped
    - **#7** OTA progress events — `_emit_step()` in `server/app/cloud/ota.py`
    emits per-step progress to the cloud (`ota_step` channel via
    `forward_event`); split `_promote_and_restart` into `_promote` +
    `_restart_unit` so emit points are explicit. Cloud relay persists into
    `ota_progress_events` and exposes `GET /devices/{id}/ota-events?limit=N`.
    - **#12+#13** ESP32 coredump + MQTT log forwarding — new
    `firmware/p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
    [partitions.csv]
2026-05-02 docs: v4.0.0 audit — refresh CHANGELOG, README, architecture diagrams + relay/data-flow narrative
    CHANGELOG.md — replaced the v4.0.0 TODO skeleton bump.sh inserted with the
    real release content (OTA progress emit, Ed25519 OTA bundle signing
    helpers, Pi UI v4 dist refresh, ota.py simplification −136 LOC,
    settings_router.py simplification −26 LOC, lockstep version bump).
    firmware/CHANGELOG.md — same: replaced the TODO skeleton with the real
    v4.0.0 firmware delta (partitions.csv with 64 KB coredump slot at
    0x3F0000, coredump.{h,cpp} uploadIfPresent, log_forward.{h,cpp}
    SP_LOG() ring buffer drained over MQTT, four-node setup() wire-up,
    explicit "no GPIO/I2C/PWM pin changes" callout pe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
2026-05-02 release: v4.0.1 — lockstep version bump (no Pi-side changes)
    v4.0.1 is a parent-cloud hotfix release covering the v4.0.0 cutover
    gaps + the missing public landing page. No Pi server, UI, or firmware
    deltas; the bump is purely the lockstep heartbeat-string update so
    release-guard.sh's invariant stays green.
    [test_api.py]
2026-05-02 release: v4.0.2 — lockstep version bump (no Pi-side changes)
2026-05-02 release: v4.0.3 — lockstep version bump (no Pi-side changes)
2026-05-02 release: v4.0.4 — lockstep version bump (no Pi-side changes)
2026-05-02 release: v4.0.5 — lockstep version bump (no Pi-side changes)
2026-05-03 release: v4.0.6 — lockstep version bump (no Pi-side changes) (#16)
2026-05-03 release: v4.0.7 — lockstep version bump (#17)
    No Pi-side server / UI / firmware code changes this release. Cloud
    parent shipped a Dockerfile fix that wires the Stripe price-ID build
    args through to the Next.js client bundle so the cloud-web pricing
    page can render its Subscribe buttons. Pi side ticks the version
    strings so the SDK / firmware / UI artifacts stay aligned with the
    parent on `4.0.7`.
    [test_api.py]
2026-05-03 feat(integrations): v4.1 scaffolding for third-party device drivers (#18)
    First slice of the v4.1 Growlink-style integration grid (Grafana,
    Aranet, Pulse Grow, etc.). This commit lands the shared framework
    that every vendor driver builds on; per-driver implementations
    follow in subsequent commits.
    Pieces:
    - `app/integrations/_base.py`
    - `IntegrationDriver` ABC with `configure / start / stop /
    test_connection / health` lifecycle.
    - `IntegrationHealth` snapshot dataclass.
    - `DriverConfigError` for structured 400s from the HTTP layer.
    - Class-level `name`, `tier_required` ("free"/"premium" per
    feedback_tier_model), `config_schema` (pydantic), and
    `secret_fields` declaratio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
2026-05-03 feat(integrations): v4.1 phase 2 — Grafana / Prometheus exporter (#19)
    Free-tier driver: the Pi exposes a /metrics endpoint in Prometheus
    text format that the user's own Grafana + Prometheus (self-hosted or
    Grafana Cloud's hosted Prometheus) scrapes on a schedule. No data
    leaves the LAN unless the operator points an external scraper at it.
    - `app/integrations/grafana/`
    - `config.py` — pydantic GrafanaConfig with optional `bearer_token`,
    `include_actuator_state`, `include_contamination_metrics`,
    `include_sensor_history` knobs.
    - `exporter.py` — collect_samples() builds a fresh
    prometheus_client.CollectorRegistry on every scrape, queries
    SQLite for latest-pe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
2026-05-03 feat(integrations): v4.1 phase 3 — Aranet PRO LAN poller (#20)
    Free-tier driver. The Aranet PRO base station (~$500) bridges Aranet4
    / Aranet RADIATION / Aranet Soil sensors over 868/915 MHz radio to a
    LAN HTTP server. The Pi polls the PRO's local API on a schedule and
    publishes readings into the existing telemetry pipeline so chamber
    UI, automation rules, alerts, and the Grafana exporter all work with
    external sensors unchanged.
    Tier: free — traffic stays on the LAN (operator's Pi → operator's
    PRO base station; no SporePrint cloud roundtrip per
    feedback_tier_model).
    - `app/integrations/aranet/`
    - `config.py` — pydantic AranetConfig.
    `base_url` is normalised on sav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
2026-05-03 feat(integrations): v4.1 phase 4 — Pulse Grow cloud-API driver (#21)
    Premium-tier driver. The Pi authenticates against api.pulsegrow.com
    on the operator's behalf, polls each Pulse device's recent-data
    endpoint, and publishes readings into the existing telemetry pipeline
    under synthetic node ids `pulse:<device_id>`.
    Tier: premium per feedback_tier_model. The data path traverses our
    infrastructure (we hold the operator's Pulse credentials on the Pi
    encrypted via the integrations Fernet key, refresh tokens against
    api.pulsegrow.com, etc.). Phase 5's cloud-web settings UI will hide
    the Pulse toggle from free-tier users; the driver itself does not
    enforce the gate.
    A separate **local-discover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
2026-05-03 feat(integrations): Pulse Grow local-mode transport + integration docs (#22)
    1. Pulse Grow dual transport (local + cloud)
    --------------------------------------------
    - `app/integrations/pulse/config.py`
    Adds `transport: Literal["cloud", "local"]` plus local-mode
    fields: `local_broadcast_addr`, `local_discovery_port`
    (default 5683 — CoAP convention), `local_http_port`,
    `local_device_urls` (skips discovery when set), and
    `local_discovery_timeout_seconds`. `poll_seconds` floor
    lowered to 30 s (local has no remote rate limit).
    - `app/integrations/pulse/local_transport.py` (new)
    UDP broadcast scan + per-device HTTP poll. Tolera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
    [test_integrations_pulse.py, test_integrations_pulse_local.py]
2026-05-03 feat(cloud): Pi-side integrations RPC handler for cloud-web mirror (#23)
    The cloud relay sends `integrations_request` events to bridge
    cloud-web operators to their Pi's /api/integrations/* surface. This
    handler dispatches each request to the local registry route handlers
    and emits `integrations_response` with the result.
    Frame shapes documented in the new module's docstring. Supported
    actions: list / get_config / put_config / test / enable / disable.
    HTTPException surfaces preserve the registry's existing 4xx contract
    (404 unknown slug, 400 bad config) so the cloud-side proxy can map
    them back to HTTP status codes.
    Wired into the existing cloud connector via `integrations_proxy.attach`
    ca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
2026-05-03 chore: rebuild ui/dist from frontend/packages/pi-ui (v4.1 integrations page included) (#24)
    The pi-ui source in the parent monorepo (frontend/packages/pi-ui)
    gained an Integrations page (#22 phase 5) and a corresponding
    sidebar entry. Rebuild the compiled dist that ships with this
    submodule so the Pi LAN UI actually renders the new page.
    No source changes in this submodule — purely the compiled output
    from `pnpm --filter @sporeprint/pi-ui build` in the parent.
2026-05-03 release: v4.1.0 — third-party integration grid (Grafana / Aranet / Pulse) (#25)
    First cut of the v4.1 third-party-integration grid on the Pi. See
    CHANGELOG.md for the full Added/Changed/Notes list. Pi-side ships:
    - Integration framework (registry + encrypted settings + lifespan)
    - Grafana / Prometheus exporter (free)
    - Aranet PRO LAN poller (free)
    - Pulse Grow dual-transport driver (free local / premium cloud)
    - Cloud RPC handler powering the cloud-web mirror in the parent
    - Per-vendor docs + starter Grafana dashboard
    - ui/dist rebuilt to include the parent monorepo's new Integrations page
    Lockstep with cloud parent v4.1.0.
2026-05-03 feat(integrations): v4.1.1 lighting/HVAC driver skeletons (#26)
    Adds seven new vendor drivers to the integrations grid as defensible
    skeletons. Auto-register, full IntegrationDriver lifecycle wired,
    tolerant pydantic parsing, contract-level tests passing — but the
    exact vendor API shapes have NOT been verified against real
    hardware. Refinements based on real responses are expected to be
    additive parser branches, not structural rewrites.
    Drivers added (all under app/integrations/):
    - agrowtek (free, LAN HTTP) — GCX controller bridge
    - trane (premium, cloud) — Nexia / BAS HVAC reads
    - fluence (premium, cloud) — FluenceID lighting
    - quest (free, L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
2026-05-03 chore: rebuild ui/dist with v4.1.1 vendor schemas (#27)
    Pi-ui source picked up the new v4.1.1 vendor schemas in
    @sporeprint/design's IntegrationsPanel (Agrowtek / Trane / Fluence /
    Quest / Anden / Fohse / BIOS). Rebuild the compiled dist that ships
    with this submodule so the Pi LAN UI's /integrations page renders
    the per-vendor field labels for each new driver.
2026-05-03 release: v4.1.1 — lighting/HVAC vendor driver skeletons (#28)
    Lockstep with cloud parent v4.1.1. See CHANGELOG.md for full
    Added/Changed/Notes. Pi-side ships seven new vendor drivers
    (Agrowtek / Trane / Fluence / Quest / Anden / Fohse / BIOS) plus
    the shared HttpVendorDriver base and ui/dist rebuild.
2026-05-03 feat(integrations): v4.1.2 vendor write paths + Wemo + Kasa drivers (#29)
    Two pieces:
    1. Vendor write paths across the v4.1 grid
    ----------------------------------------
    Each writable vendor advertises its actions through a single
    dispatcher (`app/integrations/_actions.py`):
    fluence → set_dim
    fohse → set_dim
    bios → set_dim
    trane → set_setpoint
    agrowtek → set_output
    quest → set_setpoint
    anden → set_setpoint
    New routes on the Pi:
    GET /api/integrations/{slug}/actions
    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
2026-05-03 release: v4.1.2 — vendor write paths + Wemo + Kasa drivers (#31)
    Lockstep with cloud parent v4.1.2. See CHANGELOG.md.
2026-05-03 feat(integrations): v4.1.3 Tapo dual-transport driver (local KLAP / cloud passthrough) (#32)
    Local transport (free)
    ----------------------
    KLAP handshake + AES-128-CBC encrypted commands on TCP/80. Two-step
    handshake derives a session encrypt-key, sig-key, and IV-prefix from
    local_seed || remote_seed || sha1(email)||sha1(password). Subsequent
    commands are AES-CBC-encrypted with HMAC-SHA256 integrity over an
    incrementing seq counter.
    ⚠ SHA-1 in user-hash derivation is a hard wire-protocol requirement
    of TP-Link's Tapo KLAP spec — using SHA-256 here would derive the
    wrong session key and the device would reject every request.
    The integrity guarantee for KLAP traffic is provided by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
    [test_integrations_tapo.py, test_integrations_v412_writes.py]
2026-05-03 release: v4.1.3 — Tapo dual-transport driver (#34)
    Lockstep with cloud parent v4.1.3. See CHANGELOG.md.
2026-05-03 feat(integrations): v4.1.4 vendor actions in automation + signed RPC frames (#35)
    Two pieces close the v4.1 loop:
    1. Automation engine fires vendor write actions
    `RuleAction` grew three optional fields — `vendor_slug`,
    `vendor_action`, `vendor_params`. When set, the engine routes
    through `app.integrations._actions.dispatch` instead of MQTT.
    Schedule rules can now drive Wemo plugs, Tapo switches, Kasa
    dimmers, BIOS / Fluence / Fohse fixtures, Trane / Quest / Anden
    setpoints — anything the v4.1.x vendor-actions dispatcher knows
    about. The native MQTT path is unchanged for v3.x rules with no
    `vendor_slug`.
    Failure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
    [engine.py, models.py, test_integrations_v414_automation.py]
2026-05-03 release: v4.1.4 — automation vendor actions + signed RPC frames (#36)
    Lockstep with cloud parent v4.1.4. See CHANGELOG.md.
2026-05-03 feat(integrations): v4.1.5 Pi-side — session events for vendor fires + (#37)
    automation RPC channel for cloud-web rule editor
    1. Session events for vendor-action firings
    `app/automation/engine.py::_fire_rule` — when a rule fires with
    `RuleAction.vendor_slug` set, the chamber timeline row now reads
    "Rule 'night-fog' fired: kasa.set_power({ip:10.0.0.20, on:true})"
    instead of the misleading legacy
    "Rule 'night-fog' fired: vendor:kasa/None → on"
    Audit payload (`automation_firings.action_taken`) gains
    `vendor_slug` / `vendor_action` / `vendor_params` fields so
    post-mortem queries can filter on them.
    2. Automation RPC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
2026-05-03 release: v4.1.5 — Pi-side health sweeper + state-snapshot pusher (#38)
    Closes the gap that was making v4.1.5's push-triggers + escalation
    + fleet-cache plumbing surface-area-without-emitter:
    1. New `app/integrations/_health_sweeper.py`
    - `run_health_sweeper()` — long-running asyncio task that polls
    every registered driver's `health()` once per minute. Diff
    against the per-slug last-known state; on transitions out of
    `ok`, emit `vendor_health_degraded` via `cloud.service.forward_event`.
    On transitions back into `ok`, emit the same event with
    `resolved=True` so the cloud's escalation engine can clear the
    pending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
    [test_api.py, test_integrations_tapo.py]
2026-06-13 fix(hardware): June 2026 BOM audit — boards match firmware targets, 3-bay sensor mount, branded models (#39)
    - hardware_guides: ESP32-WROOM-32 documented as the node board (matches the
    esp32dev firmware target + every wiring diagram); AI-Thinker ESP32-CAM as
    the camera (matches esp32cam); SCD41 sourcing notes refreshed; prices
    re-baselined incl. 2026 Raspberry Pi pricing; tier estimates recomputed;
    Tier 3 load cell + reed switch flagged "firmware support planned".
    - wiring SVGs: node labels corrected (ESP32-WROOM-32 / micro-USB); no pin
    changes.
    - models: sensor_mount redesigned with three bays sized for the canonical
    Adafruit breakouts + working lid vents (previous lid vent cu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
    [cam_mount.scad, esp32_case.scad, fan_duct.scad, pi_case.scad, power_supply_mount.scad, sensor_bracket.scad, sensor_mount.scad]
2026-06-13 Firmware v2: unified node + camera images, portal provisioning, TLS, host-tested core (v4.2.0) (#40)
    * feat(firmware): v2 phase 1 — native-safe core library with golden-vector parity
    New lib/sp_core (no Arduino dependencies — runs on the host):
    - canonical_json: raw-token JSON canonicalizer matching Python's
    json.dumps(sort_keys=True, separators=(",",":")) byte-for-byte. Copies
    number/string lexemes verbatim (a parse→reserialize approach cannot —
    integral floats lose their ".0"), sorts members recursively, strips the
    top-level signature, and fails closed on non-ASCII / escaped keys /
    duplicate keys / depth.
    - hmac_verify: frame verification with the 30s replay window over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
    [partitions_8mb.csv]
2026-07-04 feat(ui): Substrate II — rebuild ui/dist from @sporeprint/pi-ui @ e241931
    Built from sporeprint-cloud branch visual-refresh-p3-pi @ e241931.
    Cutover of the compiled Pi LAN UI onto the Tailwind v4 design system:
    all 21 pi-ui pages + AppShell/PiTopBar migrated to token utilities +
    @sporeprint/design primitives, layered-coexistence Vite wiring, live-dot
    hotfix included. MERGE AFTER the cloud source PR
    (59psi/sporeprint-cloud#38).
    Claude-Session: https://claude.ai/code/session_019n4NGTxCaTCzfn8Wz1rMmG
2026-07-12 firmware: sensor completeness — SCD30/MH-Z19C CO2 cal, HX711 tare+scale, reed health
    - calibrate_co2 now dispatches to whichever CO2 sensor is present:
    SCD4x FRC (0x362F, unchanged), new SCD30 FRC (0x5204, applied in
    continuous mode — no stop/restart dance), or MH-Z19C zero-point cal
    (0x87, targets 400 ppm fresh air — the ppm arg is ignored and the
    log says so). The boolean v1 form stays refused. Previously the
    command was silently dropped on SCD30 / MH-Z19C nodes.
    - Mhz19::begin(bool abc_enabled = false) makes ABC caller-controlled
    (default off, the chamber posture); calibrate_zero() added.
    - HX711 gains tare ({tare:true}) + scale calibration
    ({calibrate_scale:<known_gra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
2026-07-12 server: persist weight_g + door_open telemetry; BOM copy reflects shipped sensors
    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
2026-07-12 server: weight_g + door_open reach Grafana export and automation rules
    Persisting them wasn't enough — the Grafana exporter's sensor allowlist and
    the automation engine's readings filter would both have silently dropped
    them, so you could not graph substrate weight or write a 'door left open'
    rule. Both allowlists now carry the new metrics.
    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
2026-07-12 bom: lighting node wiring documents all 4 PWM channels
    The lighting personality drives white/blue/red/far_red on GPIO 25/26/27/14
    (firmware personality.h + SP_CHANNEL_PINS), and the All-the-Things tier sells
    the 660nm red and 730nm far-red strips — but the wiring section said
    'Lighting (2 PWM channels)' and only landed white (25) and blue (26). You
    could buy the strips with nowhere to connect them. Adds the two missing
    wiring rows and corrects the channel count.
    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
    [hardware_guides.py]
2026-07-12 feat(automation): validate rule channels against the node's reported channel list
    Channel names in automation rules are MQTT command routing keys — the node
    dispatches cmd/<channel> by exact match and logs-and-drops anything it doesn't
    recognise. Rule channels were free-form text, so a misnamed channel would save,
    fire, and write a "fired" audit row while the actuator never moved.
    The concrete bug: firmware + BOM call relay ch4 `aux` (GPIO 14 → peristaltic
    pump → misting nozzle); the frontend demo data called it `mister`. A user who
    authored a humidity rule for `mister` got a silent no-op.
    Nodes already enumerate their real channel names in the health doc; the Pi was
    discarding it. N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
    [engine.py, router.py, service.py, test_automation_channel_validation.py]
2026-07-13 fix(bom): 2026-07 refresh — repair unpurchasable parts, correct prices, pin ASINs
    Live audit of all 42 parts / 48 URLs (no dead links, but 12 broken listings).
    Unpurchasable as specified — fixed:
    - Blue 450nm strip: the Amazon search returns ZERO true-450nm products. Generic
    decorative blue 5050 is ~465-470nm — the wrong wavelength for the Cordyceps
    capability Tiers 2/3 advertise. The link "worked," so the buyer got the wrong
    part and the feature silently underperformed. Repointed to SuperLightingLED's
    450+660+730nm tri-spectrum strip, which is real and in stock. In Tier 3 the
    one strip replaces the separate blue/red/far-red trio (the red 660nm search
    had the same rot: no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
    [hardware_guides.py]
2026-07-13 fix(hardware): wiring rows now match what each tier actually buys
    Tier 3 does `*TIER_RECOMMENDED.wiring` — it SPLATS Tier 2's rows and appends a
    delta. So the red/far-red lighting rows added in 13c3417 landed in Tier 2, which
    buys neither strip and whose own limitations say "Two-channel lighting only".
    Builders were told to wire strips they never purchased. Moved to Tier 3's delta,
    where the strips are actually sold.
    Also, in Tier 3 both rows now land on the ONE tri-spectrum strip's 660/730nm
    leads (see the BOM refresh — it replaced the separate blue/red/far-red strips).
    Two gaps this surfaced, both cases of a connection existing in the SVG and the
    component notes but NOT in the struct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
    [hardware_guides.py]
2026-07-13 fix(contract): camera frames, scene rules, and plug rules all reached nothing
    Three features that reported success and did nothing. Same root class as the
    cloud's 0°F fleet tiles: the layers agree on names but not on the wire, and
    neither MQTT nor FastAPI fails loudly when they disagree.
    1. THE ESP32-CAM VISION PIPELINE HAS NEVER WORKED.
    The cam firmware POSTs its JPEG as a raw `image/jpeg` body (esp_http_client
    has no multipart encoder). `/api/vision/frame` declared
    `file: UploadFile = File(...)`, which only parses multipart — so FastAPI
    422'd every frame before the handler ran. Reproduced:
    {"detail":[{"type":"missing","loc":["body","file"]}]}
    Not one frame from real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
    [engine.py, hardware_guides.py, router.py, smart_plugs.py, test_automation_routing.py, test_firmware_wire_contract.py, test_vision_ingest_contract.py]
2026-07-13 fix(wiring): Tier 3 SVG + reed pull-up correctness (end-to-end reconciliation)
    Full pin reconciliation across firmware macros ↔ structured wiring rows ↔ SVG
    diagrams, all three tiers: the PIN CONTRACT is 100% consistent (I2C 21/22,
    channels {25,26,27,14}, HX711 32/33, reed 35, MH-Z19 UART 16/17) with zero
    within-node collisions. Two representations lagged the corrected BOM:
    - BUILD-BLOCKING: the Tier 3 SVG labeled the reed on GPIO 35 as "INPUT_PULLUP"
    in two places. GPIO 34-39 are input-only with no internal pull, so that is
    physically impossible — a builder trusting it omits the external 10K, floats
    the input, and gets phantom door-open/close events. Now says EXTERNAL 10K to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
    [hardware_guides.py]
2026-07-13 feat(pi): close the dropped-data follow-ups — actuator events, heartbeat diagnostics, plug safety-off, Pulse dew point
    Four gaps from the wire-contract audit, all "emitted but consumed by nothing":
    - actuator_events finally has a writer. The relay bank reports
    telemetry/<channel> {channel,state,pwm,trigger} on every command, safety
    cutoff, and 60s cadence; those frames fell into the sensor path where
    store_bulk_readings stored nothing, so the actuator_events table — whose
    columns mirror this doc exactly — sat unwritten and Grafana's
    actuator_event_count was permanently zero. Channel reports now insert a row,
    emit `actuator_state` (not `telemetry`), skip the automation engi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
    [engine.py, hardware_guides.py, test_actuator_events_ingest.py, test_automation_routing.py, test_integrations_pulse.py]
2026-07-13 docs: step-by-step hardware build guide + fix stale Tier 3 setup steps
    New docs/hardware-build-guide.md — parts to first telemetry, assuming nothing.
    Every pin, price, and dimension in it is the one the shipped firmware and the
    current BOM actually use. Covers the traps that cost a rebuild: wavelength
    strips can't be bought on Amazon, the cam has no USB, the SCD30 won't fit the
    printed mount, the reed needs an external pull-up, and the config-flag sensors
    (scale/door/MH-Z19) are never autodetected — tick the box or they stay silent.
    Includes a bring-up checklist where each step proves the previous one, and a
    symptom→cause table. Linked from the README as the entry point.
    Also fixes st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
    [hardware_guides.py]
2026-07-13 models: audit + fix enclosures, add HX711 scale + pump bracket
    Audited all 8 OpenSCAD models against the current (2026-07) BOM and
    re-verified every board footprint against vendor "Product Dimensions".
    sensor_mount.scad — the 2026-06 three-bay redesign still did not fit its
    boards. SHT31-D (18.0x12.7) and BH1750 (25.3x17.7) bay widths were
    transposed (BH1750 never fit); all bays shared one 23.5mm depth (only the
    SCD41 seated); the corner "M3 holes" opened out through the wall; the side
    zip-tie slots missed the body. Now per-board width AND depth, mounting on
    real end ears, chimney venting preserved. Adds scd30=true wide-bay variant
    for the SCD30 (Adafruit 4867, 51x25.4) in-stock alternate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
    [esp32_case.scad, hx711_scale.scad, pump_bracket.scad, sensor_bracket.scad, sensor_mount.scad]
2026-07-14 fix(broker): the Pi could never talk to its own nodes — MQTT ACL had no `server` user
    This is the bug a bench build would have hit in the first five minutes, and
    nothing in the repo could have caught it: Mosquitto denies unauthorized
    publishes and subscriptions SILENTLY. No error to the client, no log the
    operator sees — messages simply don't flow.
    1. THE ACL HAD NO `user server` BLOCK.
    mosquitto.conf sets allow_anonymous false. setup.sh provisions exactly one
    account for the Pi — username `server`. acl.conf defined sp-cmd,
    sp-telemetry, and sp-3p, but never `server`, so the account the server
    actually connects with fell through to the per-node %u patterns
    (sporeprint/s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
    [hardware_guides.py, test_mqtt_acl_contract.py]
2026-07-14 feat(automation): make the schedule species-driven — photoperiod, FAE period, working cron
    The species profiles specify light_hours_on/off, light_spectrum, light_lux_target,
    fae_mode, fae_interval_min, and fae_duration_sec for every phase of every
    species. Grep for their consumers and there were NONE — outside the model
    definition and the data file itself, nothing in the codebase ever read them.
    The scheduler ignored the grow profile entirely and used hardcoded literals.
    What that meant in a real grow:
    - THERE WAS NO PHOTOPERIOD. The "Light Scene — Fruiting" rule re-asserted a
    fixed scene every 60 minutes, so fruiting lights ran 24/7 and the dark period
    did not exist. Photoperiod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
    [engine.py, models.py, templates.py, test_automation_engine.py, test_automation_scheduling.py]
2026-07-14 fix(cloud): handle a lapsed subscription as a standing state, not a fault
    The cloud now refuses a device whose owner has no active subscription
    (`subscription_required` at connect, 402 on REST ingest — sporeprint-cloud
    PR #48 closed that hole: device ingest had NO entitlement check, so a lapsed
    user's already-paired Pi could push forever).
    The Pi had no idea what to do with that. Its connect loop treated every
    exception identically — exponential backoff capped at 5 minutes, retrying
    forever. Against a refusal that clears only when the user resubscribes, that
    gives you:
    - a reconnect every 5 minutes, indefinitely, against a relay that has
    reconnect-storm detection. The Pi would look l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
    [service.py, test_cloud_subscription_refusal.py]
2026-07-15 fix(automation): CO2 rules must respect phase and fae_mode — stop venting colonization
    Three independent CO2 research passes found the same defect, and I verified it:
    the FAE and exhaust rules had no phase gate, and the profiles' fae_mode was set
    49 times and read ZERO times. So during colonization — when mycelium wants CO2
    held at 5000-15000ppm with zero fresh air (Stamets & Chilton) — the fans ran
    anyway, venting exactly what the mycelium needs and drying the substrate.
    p. tampanensis' own note says "No opening, no FAE. Patience is the entire
    technique" for a 60-120 day sealed jar; the engine ran a fan at it the whole
    time. The profile stated the right thing in a field nothing read.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
    [engine.py, models.py, templates.py, test_automation_co2_gating.py]
2026-07-15 feat(automation): every BOM actuator is now environment-driven + capability-aware humidity
    Three actuators the BOM sells had ZERO rules and never ran automatically:
    circulation fan (Tier 2+), dehumidifier plug (Tier 3), misting pump (Tier 3).
    We shipped the hardware and the software never actuated it. Now:
    - Circulation Cycle — a steady low-PWM internal-air cycle during fruiting so the
    chamber doesn't stratify (CO2 pooling low, RH pockets, uneven pin drying).
    It stirs existing air, not fresh — NOT an air-exchange channel — so it runs
    even under fae_mode="none". Cadence is species-driven (new optional
    circulation_interval_min), falling back to the rule default.
    - Dehumidify + c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
    [engine.py, models.py, smart_plugs.py, templates.py, test_actuator_coverage.py]
2026-07-15 feat(lifecycle): cold storage phase, the colonization fork, and sealed-container gating
    The product spec's shape: inoculate (agar/LC/grain/bag) → colonize → a grow BAG
    goes on to fruit; everything else is pulled and parked in the fridge. And the
    CO2/RH sensors read chamber air, not the inside of a sealed vessel, so the
    chamber's environmental control can't reach a sealed bag or jar.
    - GrowPhase.COLD_STORAGE — fully-colonized agar/LC/grain holds here. Species-
    agnostic fridge params (35-40°F, no light, no FAE, CO2 uncapped so it's never
    vented); the engine applies them without every species needing to define the
    phase.
    - The fork: sessions.suggested_next_phase() + GET /sessions/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
2026-07-15 feat(lifecycle): flush loop — rest→re-fruit until the bag is spent
    The harvest data model already existed (harvests table, flush_number, per-flush
    yield aggregation). What was missing was the LIFECYCLE the spec describes: "2-3
    flushes per bag" — fruit → harvest → rest → re-fruit, until the bag is spent.
    Before this, REST advanced linearly to COMPLETE, so there was no way to loop back
    for a second flush and no signal that a bag was done.
    - sessions.flush_status(session_id) — counts DISTINCT flushes harvested (two
    picks off one flush count once), reads the species' flush_count_typical, and
    reports more_expected. GET /sessions/{id}/flushes exposes it.
    - suggested_next_phase g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
    [router.py, service.py, test_flush_lifecycle.py]
2026-07-15 feat(vision): harvest signal — alert when fruiting slows
    The last piece of the spec: "cameras would monitor for contamination, fruiting,
    and alert when fruiting SLOWS so you know about when to harvest." Contamination
    detection already existed; the fruiting/harvest side did not.
    The camera can't measure growth to the millimetre, so the signal is the model's
    per-frame stage read corroborated across frames (I'm being explicit about that
    rather than pretending we do pixel-level growth deltas):
    - The Claude vision prompt now also returns growth_rate ("expanding"|"slowing"|
    "stalled"), reading the cues that mean a fruit has plateaued (caps flattening/
    upturning, veils breaking, spores dropp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
    [service.py, test_vision_harvest_signal.py]
2026-07-15 data(species): apply the sourced CO2 corrections, provenance + category schema
    Applies the consolidated master apply-list (.superpowers/sdd/
    species-data-master-applylist.md) now that the engine honours it (CO2 rules
    phase-gated, co2_min_ppm exists, fae_mode read). 82 changes, each matched
    exactly once by (species, phase, old→new) — verified before write.
    CO2 corrections (54 co2_max_ppm + 28 co2_tolerance labels). The crop-killers:
    - button_mushroom pinning 1000→800 — Penn State: "pins develop when CO2 is
    lowered to 0.08% or lower". At 1000 the crop never pinned.
    - maitake primordia 800→2500 (interim; sourced 3000 collides with the still-
    hardcoded emergency exhaust) — it bu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
    [engine.py, models.py]
2026-07-15 fix(automation): emergency CO2 exhaust is species-relative, not a global 3000
    Salvaged the one genuine improvement from the parallel lifecycle branch
    (SporePrint#48, which otherwise duplicated already-merged work on an older base
    and cannot be merged). The hardcoded 3000ppm emergency threshold was normal —
    even low — for a reishi antler fruiting (1000-10000ppm) or a maitake rosette,
    so the global value fought species that legitimately hold CO2 high. My earlier
    merge phase-gated it (no longer fires during colonization) but left 3000
    hardcoded for fruiting, which still capped reishi/maitake below their band.
    - PhaseParams.co2_emergency_ppm = co2_max_ppm + co2_emergency_margin_ppm (1000),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
    [models.py, templates.py, test_co2_emergency_threshold.py]
2026-07-15 fix(species): correct 6 data problems found in the library audit
    An Opus audit of all 73 profiles (0 critical, 0 safety issues, every
    binomial sound, all 24 active species carry their legal disclaimer)
    surfaced a cluster of internal field-vs-prose contradictions:
    - blue_oyster: FRUITING/PRIMORDIA CO2 caps (1000/800) sat above the
    profile's OWN stated limits ("CRITICAL: >700ppm = etiolation",
    "CO2 must be <500ppm during pinning") → 700/500.
    - lions_mane: same pattern — caps (1000/700) above its documented
    deformity thresholds ("CO2 >600ppm → coral", "<500ppm pinning") → 600/500.
    - enoki: FRUITING had NO co2 floor and a low cap, so the control loop
    would drive CO2 down and pro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
    [models.py]
2026-07-16 fix(species): split GT/B+, reishi → G. lingzhi, mark woody medicinals not-food
    Maintainer decisions on the audit's held-for-review items:
    - Split the combined "Golden Teacher / B+" entry into two profiles:
    cubensis_golden_teacher (Golden Teacher) + new cubensis_b_plus (B+),
    matching the one-strain-per-profile convention (Z-Strain, Mazatapec,
    etc. each have their own). Cultivation params are identical; B+ gets
    its own descriptions (larger/meatier fruits, more forgiving). Library
    grows 73 → 74 species (active 24 → 25).
    - reishi scientific_name: Ganoderma sichuanense → Ganoderma lingzhi (the
    name most current literature uses for cultivated East-Asian reishi).
    - edible=False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
2026-07-16 fix(lifecycle): route monotub/tray to fruiting, not cold storage
    The colonization fork used _BAG_CONTAINERS = {"grow_bag", "bag"} and sent
    everything else to cold_storage — which wrongly parked monotub and tray
    (bulk substrate that fruits in place) in the fridge. Renamed to
    _FRUITING_CONTAINERS = {grow_bag, bag, bulk_bag, monotub, tray} so bulk
    containers advance to primordia_induction, matching biology and the
    session-wizard container selector (SporePrint#48). agar / liquid culture /
    grain spawn still fork to cold storage. Added regression coverage.
    Verified: full Pi server suite green.
    Claude-Session: https://claude.ai/code/session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
    [service.py, test_lifecycle_cold_storage.py]
2026-07-16 chore(ui): rebuild ui/dist from pi-ui (container selector + wired session form)
    Recompiles the Pi LAN UI bundle from frontend/packages/pi-ui so the
    committed ui/dist reflects the merged source — the session-wizard
    container-type selector and the NewSessionForm now POSTing real sessions
    to the Pi's /api/sessions. JS bundle only (CSS unchanged).
    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
2026-07-16 chore(ui): remove dead legacy build source (keep the served dist + nginx)
    The Pi LAN UI is built from frontend/packages/pi-ui (cloud repo); ui/dist is
    the committed bundle, served by the ui/ nginx container (ui/Dockerfile
    COPY dist + ui/nginx.conf, orchestrated by docker-compose). The old
    standalone Vite build source under ui/ (src/, package.json + lock,
    vite/vitest/ts configs, index.html, public/) has been dead since v4.0.0 —
    nothing builds it, no CI references it, and it carried stale vulnerable
    deps (react-router 7.14, undici, ws, vite). Removed it; kept ui/dist,
    ui/Dockerfile, ui/nginx.conf — the live serve path.
    Serve path confirmed: docker-compose `ui` service builds ./ui, whose
    D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
2026-07-16 chore(ui): rebuild ui/dist — pi-ui SessionsPage list now fetches real sessions
    Recompiles the Pi LAN UI bundle from frontend/packages/pi-ui after wiring the
    SessionsPage list to GET /api/sessions (sporeprint-cloud#63). JS bundle swap
    only; served by the ui/ nginx container.
    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
2026-07-16 feat(server): LAN system actions, contamination events + RCA, chamber lifecycle, planner events, ESP32 push-OTA
    Backend half of the Pi UI wiring project (2026-07-15 audit): the LAN UI
    had five feature surfaces with no backend. This adds them:
    - System actions (settings router): POST /api/settings/system/reboot
    (5s-grace systemctl reboot, mirroring the cloud-channel impl),
    POST /system/restart-broker (mosquitto), PUT /hostname (RFC-1123
    validated, hostnamectl + best-effort avahi restart), GET
    /system/hostname. Logic in new app/system_actions.py; static argv
    subprocess only. Fixed routes registered before the PUT /{key}
    catch-all (ordering guarded by test).
    - Contamination events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
    [models.py, router.py, service.py, test_chamber_lifecycle.py]
2026-07-16 fix(server): wire the $SYS broker-stats feed that was never subscribed
    health/service.update_mqtt_stat existed since the health dashboard
    shipped but had zero callers and mqtt.py never subscribed to $SYS —
    GET /api/health/detail/mqtt always returned {} (found by the pi-ui
    wiring audit: FleetPage's broker panel had no data source).
    Subscribe a curated $SYS/broker/* set (version, uptime, clients,
    message/byte counters, 1min load) and route the plain-text payloads
    around the JSON parse that would have silently dropped them.
    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
    [test_mqtt_sys_stats.py]
2026-07-16 chore(ui): rebuild ui/dist — the LAN UI is now wired to the real Pi API
    Built from sporeprint-cloud@2b402dc (PR #69): 20 of 21 pages fetch live
    data (chambers, telemetry, nodes, sessions, cultures, experiments,
    vision, transcripts, contamination, automation, settings) including the
    five surfaces backed by PR #56 (system actions, contamination events +
    RCA, chamber lifecycle, planner events, ESP32 push-OTA). No fake-data
    fallbacks remain.
    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
2026-07-16 chore(server): cleanup pass — bounded lists, newest-N events, single reboot path
    /simplify review findings on the #56 endpoints:
    - contamination list_events + chamber list_maintenance: LIMIT (default
    200, cap 1000) — both tables grow for the life of the install.
    - sessions get_events: optional limit keeping the NEWEST N while
    preserving the ascending contract (transcripts/reports still read the
    full history; feeds can pass a cap instead of pulling everything).
    - cloud command-channel reboot now calls system_actions.schedule_reboot()
    instead of carrying a byte-identical inline copy — one grace period,
    one systemctl invocation to maintain.
    Suite: 739 passed, 1 xfailed.
    Co-Au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
    [router.py, service.py]
2026-07-16 chore(ui): rebuild ui/dist from the simplified pi-ui (cloud#71)
    Bundle-only change: shared pi-types/chambers/usePiLoad consolidation +
    FleetPage/ChambersInventory N+1 fixes (net -339 lines of source).
    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
2026-07-16 feat(server): sessions list phase_history + remove LAN OS-mutation routes
    - GET /api/sessions gains include_phase_history=false: one grouped
    phase_history query attached per session (same shape/ordering as
    GET /{id}); default response byte-identical. Lets the fleet view
    compute day-N/M without a per-session fan-out.
    - REMOVED (product decision): POST /api/settings/system/reboot,
    POST /system/restart-broker, GET /system/hostname, PUT /hostname.
    system_actions.py slims to schedule_reboot() only - still consumed
    by the HMAC-signed cloud command channel, which remains the sole
    reboot path. No LAN-reachable OS mutation remains.
    - Tests: +3 phase-history route tests; OS-action tests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
    [router.py, service.py, test_api.py, test_system_actions.py]
2026-07-16 fix(server): close the Pi→ESP32 command-signing fail-open (observable + enforceable, cloud-aware)
    Archaeology's top finding (flagged independently by 5 analysis agents): with
    mqtt_hmac_key unset, mqtt_publish shipped cmd/* frames UNSIGNED, silently — no
    startup check, no /health surfacing, no way to enforce.
    - New SPOREPRINT_MQTT_REQUIRE_SIGNING policy (auto|always|never, default auto).
    "auto" enforces iff the Pi is cloud-configured (cloud_url set): a paired /
    managed deployment refuses unsigned commands; a pure-LAN self-host stays
    permissive (LAN-trust). Keyed off the STABLE config, not the live connection,
    so a cloud outage / DoS can't silently downgrade signing.
    - Enforced +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
    [router.py, test_mqtt_signing_enforcement.py]
2026-07-17 release: v5.0.0 — Pi prod-wiring completion + one-command Docker installer
    Automation: engine set_paused/suspend_rule + set_override 24h TTL (remote pause/suspend + override auto-resume); cloud actuator override routing (target_kind=automation). Species-id canonicalization fixes get_profile for the '_'/'-' drift (63/74 species). NEW: GET /api/chambers/{id}/automation-coverage (pre-grow hardware-capability verdict), GET /api/hardware/discover + POST /api/hardware/claim, planner propose_cycle + /api/planner/propose(.ics) with session iCal on real phases, vision auto-analysis on camera ingest (throttled + premium/BYOK). One-command install.sh (Docker+Compose, MQTT creds+TLS, LAN-trust) + hard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
    [coverage.py, coverage_router.py, engine.py, models.py]
2026-07-17 fix: wave-4 — Pi actuator addressing + remote session/telemetry (closes V3-1/2, H4-1/2)
    send_plug_command resolves by plug_id OR device_role (role-addressed climate plugs no longer silent-no-op); native-node rule targets resolve by hardware_nodes.node_type instead of hardcoded relay-01/light-01 + validate_action_channel flags unregistered targets; remote session start/end handler implemented; per-session telemetry resolves the real node by session_id. Tests updated to real MAC-derived provisioning. 837 passed.
    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
    [coverage.py, engine.py, router.py, service.py, smart_plugs.py, test_api.py, test_automation_channel_validation.py, test_automation_coverage.py]
2026-07-17 fix(cloud-proxy): wire chamber-coverage + planner-propose pre-grow actions
    The cloud-web wizard/planner forward `chamber_automation_coverage` and
    `planner_propose` to the paired Pi over the integrations RPC channel, but
    the Pi's proxy only knew the integrations + automation_* actions — every
    pre-grow request hit "unknown action" at runtime even though the cloud
    routes and the Pi helpers (coverage.compute_coverage,
    planner.propose_cycle_for_species) both existed. Cloud tests mock the
    proxy, so this seam read green on both sides yet dead-ended end-to-end.
    Add a slug-less _dispatch_pregrow branch (before the slug guard):
    - chamber_automation_coverage {chamber_id,species} -> {"phases":[...]}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
    [test_cloud_integrations_proxy.py]
2026-07-17 fix(automation,vision): safety alerts fire when paused, overrides stick, colonization detected
    Three triple-confirmed re-sweep gaps + one adjacent latent bug, on the Pi engine.
    - V5-1 (safety): evaluate_rules gated stage-aware SAFETY detection behind the
    `if _paused: return` and `if not rules: return` early returns. Pausing
    automation (or disabling all rules) for manual control silenced overheat/RH
    alerts entirely. Hoisted the active-session lookup + _check_safety_thresholds
    ABOVE those returns; pause/no-rules now suppress ACTUATION only, never
    DETECTION. +2 tests (paused, and zero-rules) that fail pre-fix.
    - V4-1 (override claw-back): the override gate checked is_overridden(rule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
    [engine.py, service.py, test_automation_remote_hold.py, test_automation_safety_always_on.py, test_vision_colonization_signal.py]
2026-07-18 test+fix(pi,firmware): comprehensive suite rebuild — safety false-alarm, rule_id contract, firmware wire-contract builders
    Part of the whole-platform test-suite audit + rebuild. Fixes 2 confirmed Pi
    bugs, hardens the firmware wire-contract, and adds real coverage the audit
    found missing (Pi 853→902 pytest; firmware 73→100 host tests).
    Pi SERVER bugs fixed (+ regression tests):
    - automation/engine.py: _check_safety_thresholds fired a low-humidity EMERGENCY
    page every telemetry frame during cold_storage (a normal ~45% fridge < the
    incidental humidity_min=80). Added PhaseParams.humidity_driven (default True,
    False for cold_storage); humidity safety is now ceiling-only when the phas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
    [engine.py, main.cpp, models.py, service.py, test_auth_middleware.py, test_automation_safety_always_on.py]
2026-07-18 fix(firmware): reword wire_contract.h comment so the Arduino-free CI guard stops flagging itself
    The native-tests job greps sp_core/sp_drivers for `include [<"]Arduino.h`.
    The header's own comment quoted that exact substring while explaining the
    guard, so the guard flagged its own documentation and failed the job — even
    though the 100 host tests all passed. Reworded to keep the meaning without
    the literal substring. Host suite still 100/100; the real
    `#include <ArduinoJson.h>` on line 28 is unchanged (the guard correctly
    ignores ArduinoJson.h).
    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
2026-10-07 Release 5.1.0 (#66)
    SporePrint 5.1.0 — hardware/BOM audit, Arduino-ESP32 core 3.3.12, drivers
    for every part the BOM has listed, signed firmware releases, Shelly Gen2+,
    shiitake browning phase, coredump acknowledgements, signed OTA manifests,
    dependency refresh, and a full docs and diagram pass. Release notes:
    CHANGELOG.md and firmware/CHANGELOG.md, section [5.1.0].
    Claude-Session: https://claude.ai/code/session_01UT1fVguz9WGVoBraKAq4iU
    [cam_mount.scad, esp32_case.scad, fan_duct.scad, hx711_scale.scad, partitions.csv, partitions_32mb.csv, partitions_8mb.csv, pi_case.scad]
2026-10-07 release: 5.1.1 (lockstep version bump)
    Lockstep version bump in step with the cloud parent — no Pi-side server,
    UI, or firmware code changes in this release.
    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
2026-10-07 feat(cloud): send grow sessions and contamination events to the cloud
    Nothing on the Pi ever sent its sessions, harvests or most contamination
    events to the cloud, so the cloud's sessions, analytics, planner, chamber
    tiles and contamination history could only stay empty for a real grow.
    - app/cloud/session_sync.py builds a snapshot of a session (status, phase
    and when it began, the phase's expected length, species, totals, flushes,
    harvests) and sends it as `session_sync` after every change: create,
    edit, phase advance, harvest, complete/abort. Every recorded
    contamination event (vision, identify, manual) goes out as
    `contamination_event`.
    - Anything that cannot be sent is kept an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
2026-10-07 fix(automation): give Pis seeded by an older release the newer built-in rules
    seed_builtin_rules only inserted BUILTIN_RULES into an empty table. A Pi
    first booted before the CO2 Hard Ceiling safety backstop and CO2 Floor —
    Restrict FAE were added never got either, and nothing said so. Each
    built-in is now offered once: a name this Pi has not been given is
    inserted (unless a rule by that name exists) and recorded in
    user_settings, so later built-ins reach existing installs and a built-in
    the operator deletes stays deleted. The boot log names what was added.
    Claude-Session: https://claude.ai/code/session_01UT1fVguz9WGVoBr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
    [service.py, test_automation_service.py, test_browning_phase.py]
2026-10-07 docs(relay): document the Pi's session and contamination sync
    cloud-relay-flow.md gains the session_sync / contamination_event flow:
    what the Pi sends and when, the reconnect resend and backfill, the
    source mapping, how the cloud keys rows by the Pi's local ids, and why a
    vision alert is not stored twice.
    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
2026-10-07 fix(cloud): ship the transport the cloud connector needs to connect
    python-socketio's asyncio client (the connector's AsyncClient) needs
    aiohttp for its HTTP/WebSocket transport, and nothing in the locked
    dependencies pulled it in: every connect failed with "aiohttp package not
    installed", so a Pi installed from the lock or the Docker image could never
    reach the cloud (no telemetry, commands, OTA progress or sync). The Pi now
    depends on python-socketio[asyncio_client]; a test checks the extra is
    declared, locked and importable. Found by running a Pi against a local
    cloud relay end to end.
    Claude-Session: https://claude.ai/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
    [test_cloud_connector_transport.py]
2026-10-07 Release 5.2.0
    Grow sessions and contamination events now reach the cloud (session_sync /
    contamination_event, resent on reconnect, backfilled on connect); the cloud
    connector's missing transport dependency is fixed; Pis seeded by an older
    release get the newer built-in rules.
    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
    [test_api.py]
2026-10-07 docs(readme): make the front door match the site and the code
    The README is where every Free call to action lands. It now says plainly
    what is open source (Pi server, ESP32 firmware, enclosure models under
    AGPL-3.0) and what is not (the Pi dashboard ships as a pre-built bundle;
    the sporeprint.ai cloud is proprietary), how to install and update
    (git pull && ./install.sh), how pairing works, which integrations are
    untested on hardware, and carries the education-and-research notice
    wherever the active category is mentioned. test_readme_front_door.py pins
    those claims to the code.
    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
2026-10-20 Fix 312 verified Pi, firmware and ops defects from a full-codebase audit (#82)
    * fix(firmware): safety, OTA, transport and driver fixes from the full audit
    65 files.
    Claude-Session: https://claude.ai/code/session_01KMGQus3Sje5Cpx3nzbqz9S
    * fix(server): automation engine, built-in rules and smart-plug fixes
    43 files.
    Claude-Session: https://claude.ai/code/session_01KMGQus3Sje5Cpx3nzbqz9S
    * fix(server): cloud link, pairing, OTA push and node command fixes
    34 files.
    Claude-Session: h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
2026-10-20 fix(automation): keep a grow in no chamber off other chambers' nodes (#85)
    For nodes in no chamber, the relay-01 / light-01 placeholders resolved to
    whichever node of the role was seen last, even one a chamber running its
    own grow lists, so a closet grow's FAE or light-scene rule switched that
    chamber's fan or light. resolve_node_target now takes the steps
    chamber_plug takes for a plug role: a node no chamber lists, else one of
    a chamber that runs the same grow, never one of a chamber running a grow
    of its own; with none, the rule does not fire. With no grow given (rule
    validation, coverage) it keeps the most-recently-seen pick.
    Docs: name each chamber's plugs after the chamber (heater-a),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
2026-10-20 deps(server): update python-socketio[asyncio_client] requirement (#77)
    Updates the requirements on [python-socketio[asyncio_client]](https://github.com/sponsors/miguelgrinberg) to permit the latest version.
    - [Commits](https://github.com/sponsors/miguelgrinberg/commits)
    ---
    updated-dependencies:
    - dependency-name: python-socketio[asyncio_client]
    dependency-version: 5.17.0
    dependency-type: direct:production
    ...
2026-10-20 test: check pins and security floors by intent, not exact versions (#86)
    Two tests failed as soon as Dependabot bumps merged:
    - test_docker asserted compose runs exactly ntfy v2.28.0, so the bump to
    v2.30.0 failed it. It now checks the image is pinned to an exact release
    tag (never a moving one), which is what the pin is for.
    - test_dependency_floors required each security floor to admit the exact
    fixed release, so raising python-socketio's floor to 5.17.0 failed it.
    It now checks the declared floor is at or above the fixed release and
    still excludes the vulnerable one.
    Pi suite: 3696 passed, 18 skipped.
    Co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
2026-10-21 Release 5.2.3 (#88)
    * build(ui): rebuild the dashboard bundle from the current source
    The frontend dependency updates changed the pi-ui build output, so
    ui/dist is synced from a fresh `vite build` of frontend/packages/pi-ui
    (pi-ui: typecheck clean, 578/578 tests).
    * chore(security): mark the vetted Semgrep findings
    Semgrep flagged statements the review touched. Each one was checked and
    is safe, and is now marked in the codebase's existing style (a nosemgrep
    line with the reason):
    - SQL built from module constants, integer bucket widths or allow-list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
