59psi/SporePrint/(notices)

Notices in the files:
README.md:
License: AGPL-3.0
